Rutherfurrd/Sakura-1---High-Voltage-Power-Distribution-System/MPPT Breakout/jlcpcb/production_files/BOM-MPPT Breakout.csv

Comment | Designator | Footprint | LCSC | Quantity
Wurth 657002230101 | J5 | 657002230101 |  | 1
10A FC-203 | F3 | Fuseholder_Clip-5x20mm_Bel_FC-203-22_Lateral_P17.80x5.00mm_D1.17mm_Horizontal |  | 1
10A FC-203 | F1 | Fuseholder_Clip-5x20mm_Bel_FC-203-22_Lateral_P17.80x5.00mm_D1.17mm_Horizontal |  | 1
1N4007WS | D2 | D_SOD-323_HandSoldering |  | 1
Wurth 657002230101 | J4 | 657002230101 |  | 1
Wurth 657002230101 | J6 | 657002230101 |  | 1
Molex 2218873321 | J3 | CONN_2218873321_KEYOPT1_02P_MOL |  | 1
10A FC-203 | F2 | Fuseholder_Clip-5x20mm_Bel_FC-203-22_Lateral_P17.80x5.00mm_D1.17mm_Horizontal |  | 1
Molex 5569 | J1 | Molex_Mini-Fit_Jr_5569-04A2_2x02_P4.20mm_Horizontal |  | 1
1N4007WS | D3 | D_SOD-323_HandSoldering |  | 1
1N4007WS | D1 | D_SOD-323_HandSoldering |  | 1
1N4007WS | D4 | D_SOD-323_HandSoldering |  | 1
10A FC-203 | F4 | Fuseholder_Clip-5x20mm_Bel_FC-203-22_Lateral_P17.80x5.00mm_D1.17mm_Horizontal |  | 1
Wurth 657002230101 | J7 | 657002230101 |  | 1
Wurth 657002230101 | J8 | 657002230101 |  | 1
Wurth 657002230101 | J10 | 657002230101 |  | 1
Wurth 657002230101 | J11 | 657002230101 |  | 1
Wurth 657002230101 | J9 | 657002230101 |  | 1
