Rutherfurrd/Sakura-1---High-Voltage-Power-Distribution-System/Supplementary Battery Fusebox/jlcpcb/production_files/BOM-Supplementary Breakout.csv

Comment | Designator | Footprint | LCSC | Quantity
3568 Holder | F4 | Fuseholder_Clip-5x20mm_Bel_FC-203-22_Lateral_P17.80x5.00mm_D1.17mm_Horizontal |  | 1
Molex 5569 | J8 | CONN_5569-02A_MOL |  | 1
3568 Holder | F5 | Fuseholder_Clip-5x20mm_Bel_FC-203-22_Lateral_P17.80x5.00mm_D1.17mm_Horizontal |  | 1
XT60 | J1 | XT60PWM |  | 1
3568 Holder | F6 | Fuseholder_Clip-5x20mm_Bel_FC-203-22_Lateral_P17.80x5.00mm_D1.17mm_Horizontal |  | 1
3568 Holder | F3 | Fuseholder_Clip-5x20mm_Bel_FC-203-22_Lateral_P17.80x5.00mm_D1.17mm_Horizontal |  | 1
Molex 5569 | J9 | CONN_5569-02A_MOL |  | 1
3568 Holder | F1 | Fuseholder_Clip-5x20mm_Bel_FC-203-22_Lateral_P17.80x5.00mm_D1.17mm_Horizontal |  | 1
3568 Holder | F7 | Fuseholder_Clip-5x20mm_Bel_FC-203-22_Lateral_P17.80x5.00mm_D1.17mm_Horizontal |  | 1
XT60 | J7 | XT60PWM |  | 1
Molex 5569 | J10 | CONN_5569-02A_MOL |  | 1
Molex 5569 | J12 | CONN_5569-02A_MOL |  | 1
Molex 5569 | J13 | CONN_5569-02A_MOL |  | 1
Molex 5569 | J11 | CONN_5569-02A_MOL |  | 1
3568 Holder | F2 | Fuseholder_Clip-5x20mm_Bel_FC-203-22_Lateral_P17.80x5.00mm_D1.17mm_Horizontal |  | 1
