Rutherfurrd/Sakura-1---High-Voltage-Power-Distribution-System/Mounting/IO Ports.xlsx

Sheet: External
 | Connector | Destination | Marketplace | Link
Motor Controller | ELPA2A1601 | MC | Digikey
 | ELRA2U1601 | MC | Digikey
Supp Battery | XT60 | Supp | Amazon | https://www.amazon.com/XT60E-F-Connector-Protective-Aircraft-Accessories/dp/B0BC5TK8FT
MPPT | ELP2Y03 | MPPT Breakout | Digikey
 | ELR2Y03 | MPPT Breakout | Digikey
CAN Main IN (3P) |  | Telemetry Board
CAN MAIN OUT (3P) |  | Driver Board
CAN MPPT (3P) |  | MPPT
24V Out
GND | 10 Molex Mini Fit | Button Interface | Already owned
PV1 |  | Button Interface
PV2 |  | Button Interface
PV3 |  | Button Interface
3.3V |  | Button Interface
HV_Arm |  | Button Interface
BPS_GND |  | Button Interface
LVESTOP |  | Button Interface
GND |  | Button Interface
HV ESTOP |  | Button Interface
3.3V |  | Button Interface
Coil1 | 6P Molex Minifit | MPPT Breakout | Already Owned
Coil2 |  | MPPT Breakout
Coil3 |  | MPPT Breakout
24V |  | MPPT Breakout
12V_CAN |  | MPPT Breakout
GND |  | MPPT Breakout

Sheet: CAN BUS
Single Connector
 | Sku | Qty | DPN | Price | Total
Socket | 03T-JWPF-VSLE-S | 1 | 455-1188-ND | 1.24
Socket Pins | SWPT-001T-P025 | 2 | 455-1320-1-ND | 0.063
Plug | 03R-JWPF-VSLE-S | 1 | 455-1198-ND | 0.64
Plug Pins | SWPR-001T-P025 | 2 | 455-1321TR-ND | 0.04
20 | Connectors
Socket | 03T-JWPF-VSLE-S | 20 | 24.8
Socket Pins | SWPT-001T-P025 | 40 | 2.52
Plug | 03R-JWPF-VSLE-S | 20 | 12.8
Plug Pins | SWPR-001T-P025 | 40 | 1.6
 |  | Total: | 41.72

Sheet: Sheet2
Black | 30 ft | SKU: NNC2546X
Red | 30 ft | SKU: NNC2548X
White \ | 20 ft | SKU: NNC2549X

Sheet: Internal
Batt+ | Ring Terminal
Batt- | Ring Terminal
IsoSPI | WM1847-ND | 4
 | WM1839-ND | 36
4P Fans | Already Owned
MPPT Micro Fit | WM1785-ND | 5
MPPT Terminal Blocks | 277-8714-ND | 3
