Rutherfurrd/Sakura-1---High-Voltage-Power-Distribution-System/Mounting/CAN Clamp MAIN.SLDPRT

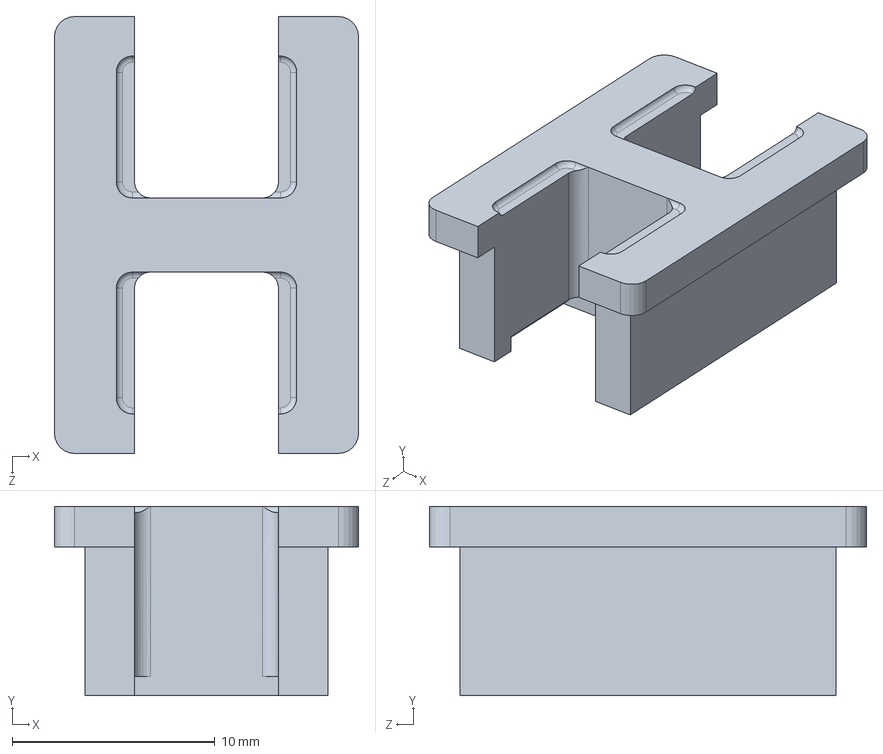
[picture p1: CAD file, 2026-10-22]
Mounting/CAN Clamp MAIN.SLDPRT
15.0 x 9.34 x 21.5 mm
