Rutherfurrd/Sakura-1---High-Voltage-Power-Distribution-System/MPPT Breakout/PCB.step

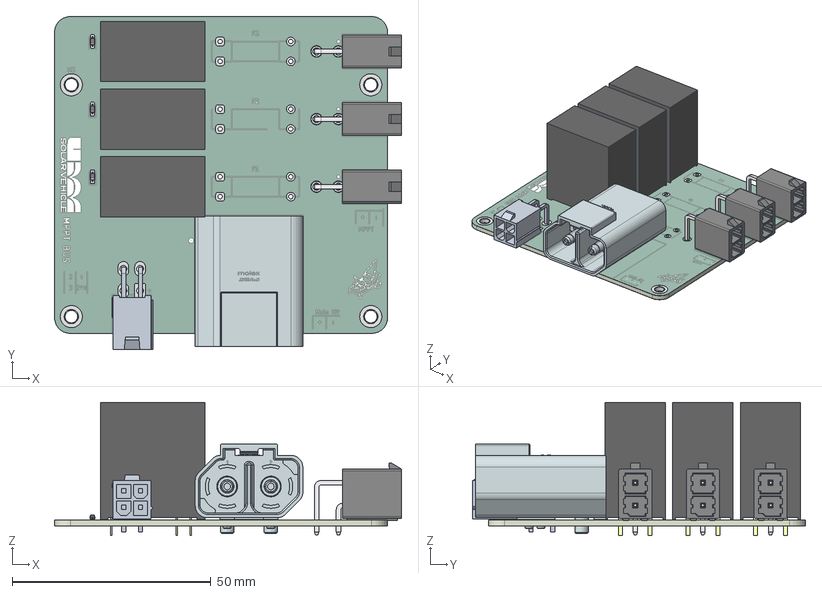
[picture p2: CAD file, 2026-10-22]
MPPT Breakout/PCB.step
87.4 x 83.8 x 33.5 mm
657002230101_Pin1 x 3
657002230101_Pin2 x 3
D_SOD-323 x 3
G5PZ-1A-X_DC24 x 3
MPPT Breakout_copper
MPPT Breakout_pad
MPPT Breakout_via
MPPT Breakout_silkscreen x 2
MPPT Breakout_soldermask x 2
MPPT Breakout_PCB
