Rutherfurrd/Sakura-1---High-Voltage-Power-Distribution-System/Supplementary Battery Fusebox/Supplementary Battery Breakout.step

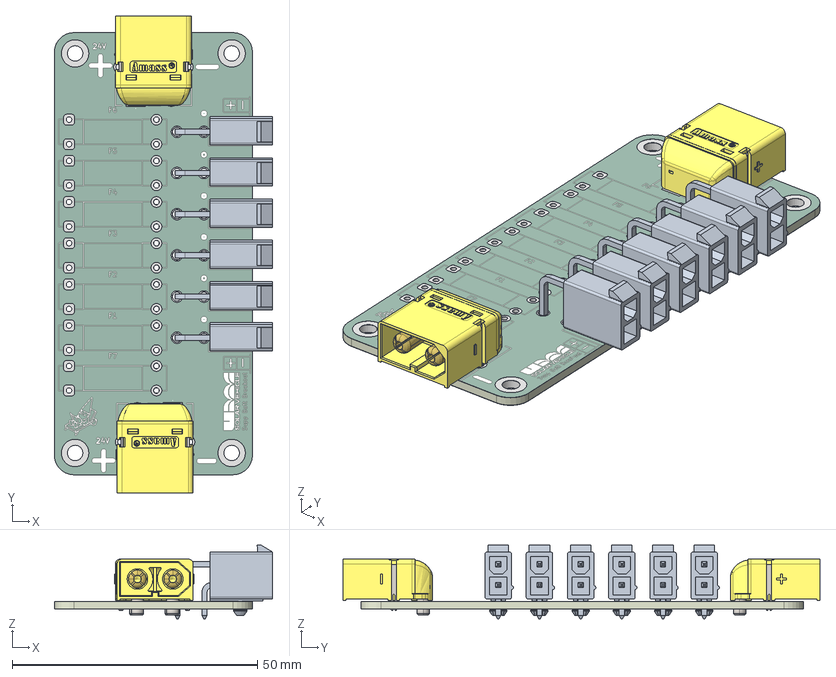
[picture p3: CAD file, 2026-10-22]
Supplementary Battery Fusebox/Supplementary Battery Breakout.step
44.5 x 97.2 x 15.0 mm
XT60PW-M x 2
Supplementary Breakout_copper
Supplementary Breakout_pad
Supplementary Breakout_via
Supplementary Breakout_silkscreen x 2
Supplementary Breakout_soldermask x 2
Supplementary Breakout_PCB
