Rutherfurrd/Sakura-1---High-Voltage-Power-Distribution-System/Mounting/CAN Clamp Right.SLDPRT

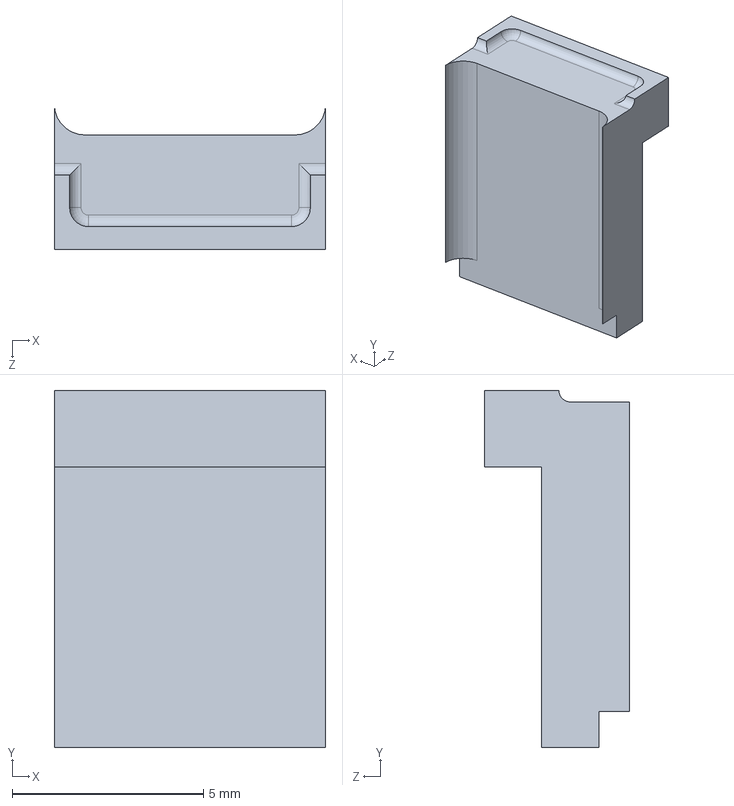
[picture p4: CAD file, 2026-10-22]
Mounting/CAN Clamp Right.SLDPRT
7.10 x 9.34 x 3.80 mm
