Rutherfurrd/Sakura-1---High-Voltage-Power-Distribution-System/MPPT Breakout/MPPT Breakout.step

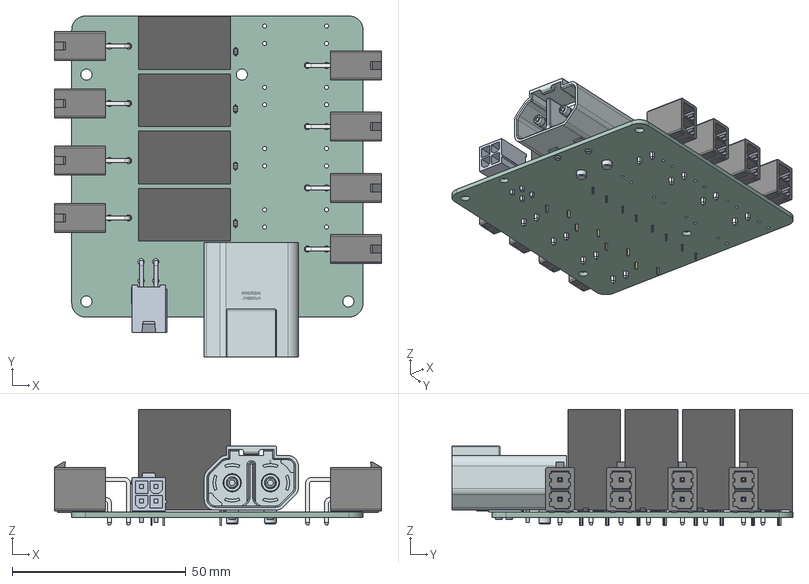
[picture p5: CAD file, 2026-10-22]
MPPT Breakout/MPPT Breakout.step
94.3 x 98.2 x 33.5 mm
657002230101_Pin1 x 8
657002230101_Pin2 x 8
D_SOD-323 x 4
G5PZ_1A_X x 4
MPPT Breakout_PCB
