Rutherfurrd/Sakura-1---High-Voltage-Power-Distribution-System/Power Distribution Board/Battery Board, No Silkscreen.step

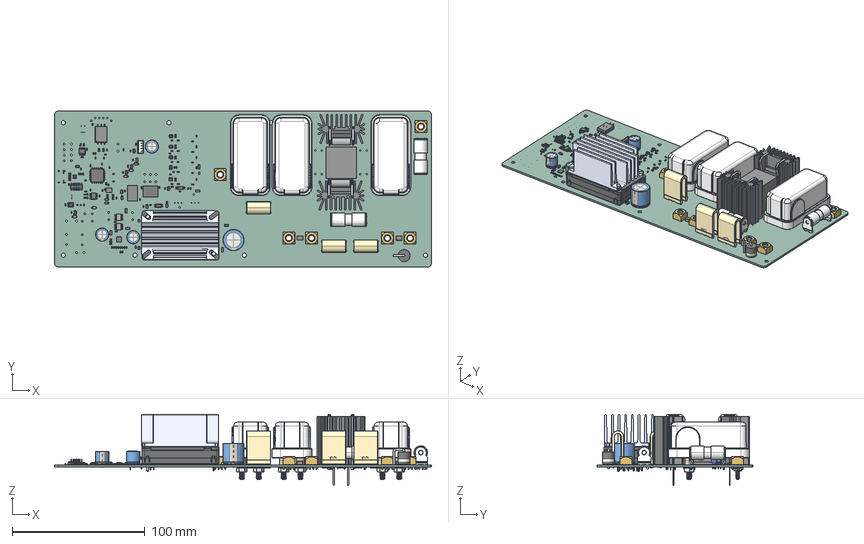
[picture p6: CAD file, 2026-10-22]
Power Distribution Board/Battery Board, No Silkscreen.step
284.3 x 117.7 x 53.8 mm
P125_step_092315 x 3
R_0402_1005Metric x 2
R_0603_1608Metric x 56
C_0603_1608Metric x 56
C_1812_4532Metric x 2
C_1206_3216Metric x 6
C_0805_2012Metric x 2
CP_Radial_D100mm_P500mm x 3
SOT-23-6 x 5
SOT-23 x 14
D_SOD_523 x 4
Converter_DCDC_RECOM_R_78E_05_THT
D_SMF x 10
CP_Radial_D160mm_P750mm
FTR-J2AK012W
R_0805_2012Metric x 3
CN100B110-24
537-95AB HEATSINK DC DC 1-4 BRICK VERT
JST_B4B_PH_K
TO-247-2_Vertical x 2
SW_SPST_PTS810
D_P600_R-6_P7.62mm_Vertical_AnodeUp
PinHeader_2x07_P127mm_Vertical_SMD
LED_0603_1608Metric
QFN-11_L4.5-W3.5-P0.50-TL_TPSM365R6FRDNR
C_0402_1005Metric x 4
D_SOD_123F x 4
SOP_4_44x26mm_P127mm x 2
SOIC-8_3.9x4.9mm_P1.27mm x 2
R_1206_3216Metric
R2A-CT4-38E x 2
RES-TH_HOFLQ60-100A-50MV-7H27 x 3
terminal
logo
TSR 1-2433E
LQFP-64_10x10mm_P0.5mm
ELV10-2P x 2
SOT-23-5
BatteryBoard_PCB
