Rutherfurrd/Sakura-1---High-Voltage-Power-Distribution-System/Supplementary Battery Fusebox/PCB.step

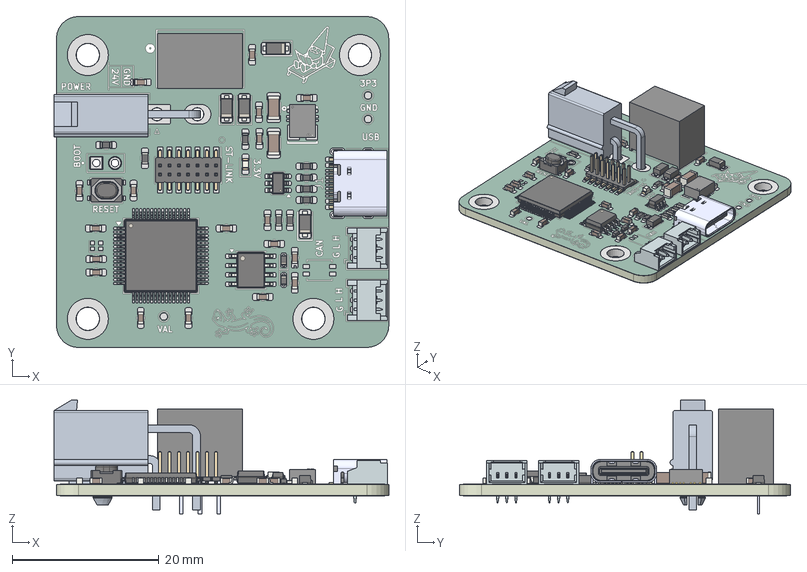
[picture p7: CAD file, 2026-10-22]
Supplementary Battery Fusebox/PCB.step
45.6 x 45.1 x 15.5 mm
D_SOD_523 x 2
530480310wbm000_01 x 2
SOT-23-6
C_0603_1608Metric x 18
R_0603_1608Metric x 9
LED_0603_1608Metric
D_SOD_123F x 4
SW_SPST_PTS810
TSR 1-2433E
PinHeader_2x07_P127mm_Vertical_SMD
SOIC-8_3.9x4.9mm_P1.27mm
C_1206_3216Metric x 2
TYPE-C-31-M-12
LQFP-64_10x10mm_P0.5mm
QFN-11_L4.5-W3.5-P0.50-TL_TPSM365R6FRDNR
Telemetry Board 25-26_copper
Telemetry Board 25-26_pad
Telemetry Board 25-26_via
Telemetry Board 25-26_silkscreen x 2
Telemetry Board 25-26_soldermask x 2
Telemetry Board 25-26_PCB
