Rutherfurrd/Sakura-1---High-Voltage-Power-Distribution-System/Power Distribution Board/spongebob_vectorized.dxf

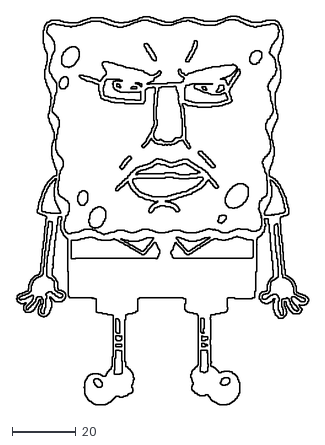
[picture p8: CAD file, 2026-10-22]
Power Distribution Board/spongebob_vectorized.dxf
91.8 x 122.0
