Rutherfurrd/Sakura-1---High-Voltage-Power-Distribution-System/Mounting/IO Insert.STEP

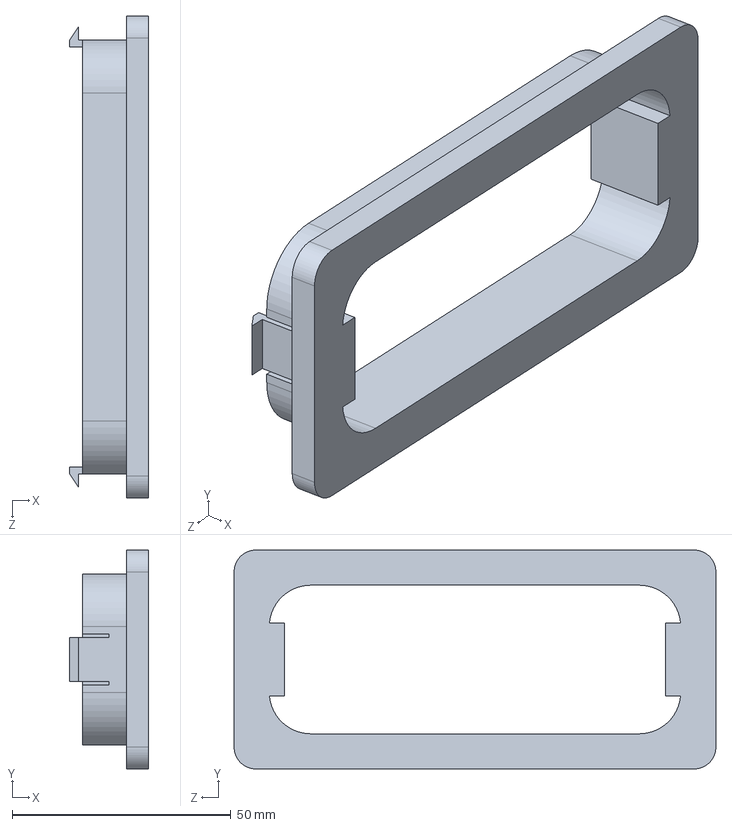
[picture p9: CAD file, 2026-10-22]
Mounting/IO Insert.STEP
18.0 x 50.0 x 110.0 mm
