Rutherfurrd/Sakura-1---High-Voltage-Power-Distribution-System/Mounting/IO-Port - Middle.STEP

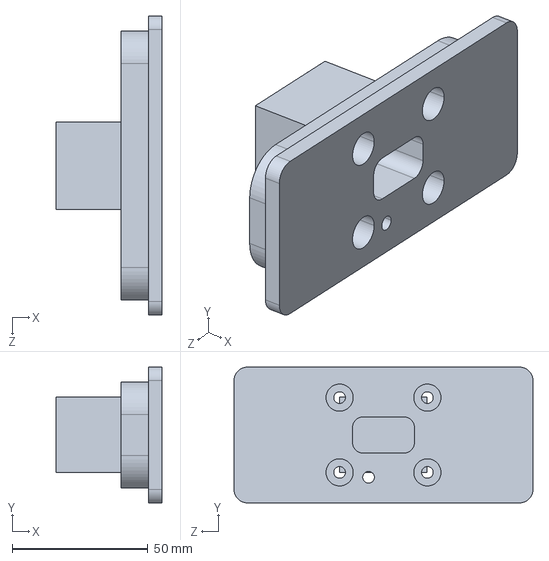
[picture p10: CAD file, 2026-10-22]
Mounting/IO-Port - Middle.STEP
39.0 x 50.0 x 110.0 mm
