Rutherfurrd/Sakura-1---High-Voltage-Power-Distribution-System/Mounting/Connector Mount.STEP

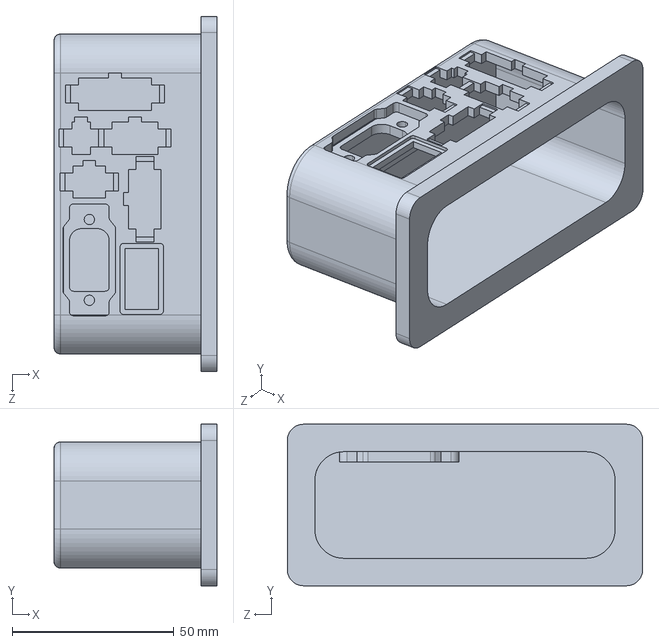
[picture p11: CAD file, 2026-10-22]
Mounting/Connector Mount.STEP
50.5 x 50.0 x 110.0 mm
