Rutherfurrd/Sakura-1---High-Voltage-Power-Distribution-System/Mounting/HV Mount Right.SLDPRT

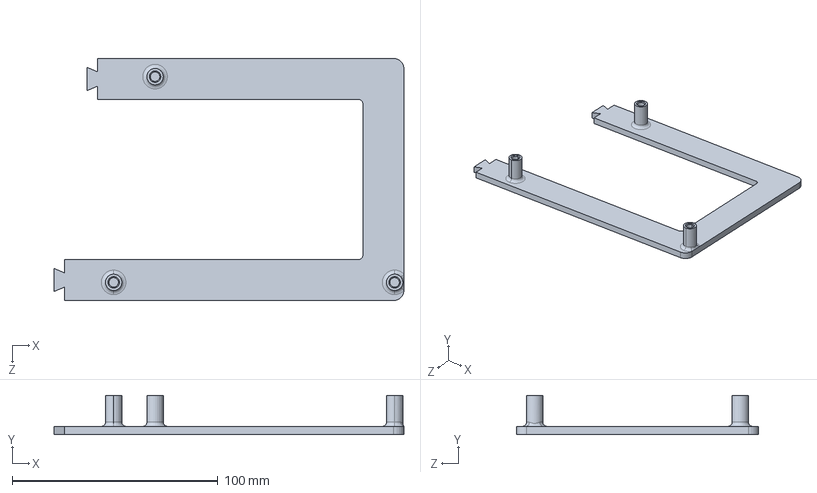
[picture p12: CAD file, 2026-10-22]
Mounting/HV Mount Right.SLDPRT
170.1 x 19.0 x 117.7 mm
