Rutherfurrd/Sakura-1---High-Voltage-Power-Distribution-System/Mounting/HV Mount Left.SLDPRT

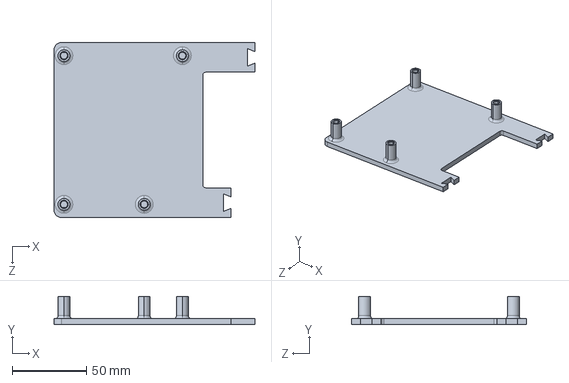
[picture p13: CAD file, 2026-10-22]
Mounting/HV Mount Left.SLDPRT
135.1 x 19.0 x 117.7 mm
