Rutherfurrd/Sakura-1---High-Voltage-Power-Distribution-System/Mounting/Batt_box.STEP

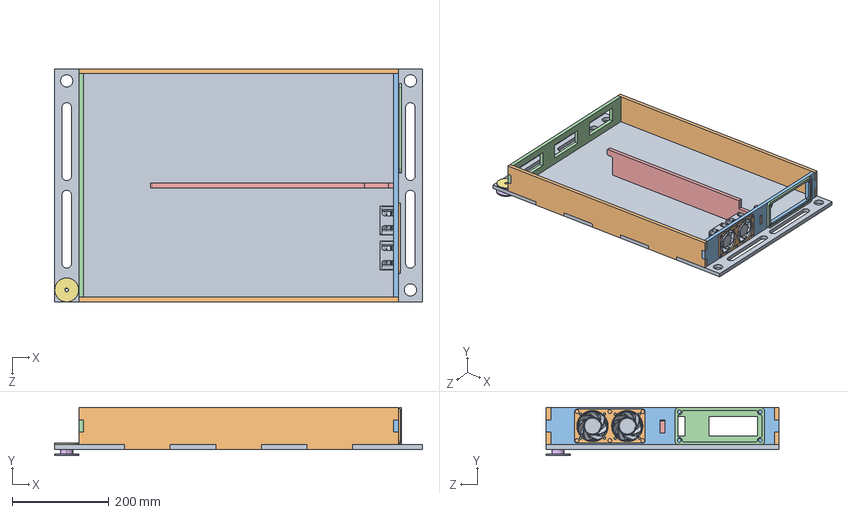
[picture p14: CAD file, 2026-10-22]
Mounting/Batt_box.STEP
761.2 x 99.3 x 482.7 mm
Baseplate
Box Side Wall x 2
Front Wall_1
Rear Wall_2
Middle Wall
Chassis insert 2
Battery Box Insert 2
94820A410_Steel Flex-Top Locknut for Heavy Vibration_94820A410
SanAce_9HV_60x38 - 9HV0612P1J001 v1 x 2
Fan_attachment
Insert_plug
