Rutherfurrd/Sakura-1---High-Voltage-Power-Distribution-System/Mounting/IO-Port - Right.STEP

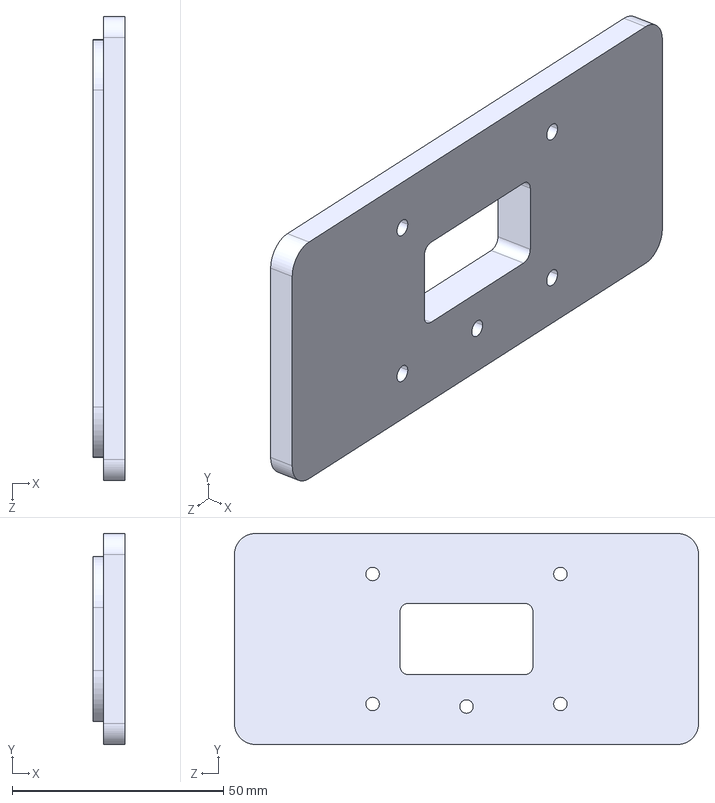
[picture p15: CAD file, 2026-10-22]
Mounting/IO-Port - Right.STEP
7.50 x 50.0 x 110.0 mm
