Rutherfurrd/Sakura-1---High-Voltage-Power-Distribution-System/Mounting/Batt_box_assem.SLDASM

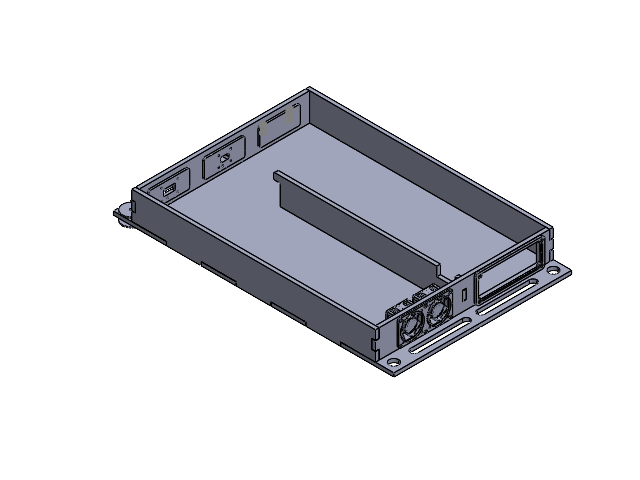
[picture p16: CAD file, 2026-10-22]
Mounting/Batt_box_assem.SLDASM
Baseplate.STEP
Box Side Wall_1.STEP x 2
Front Wall_1_1.STEP
Rear Wall_2_1.STEP
Middle Wall_1.STEP
Chassis insert 2_1.STEP
Battery Box Insert 2_1.STEP
94820A410_Steel Flex-Top Locknut for Heavy Vibration_94820A410_1.STEP
SanAce_9HV_60x38 - 9HV0612P1J001 v1_1.STEP x 2
Fan_attachment_1.STEP
Part6.STEP
Part7_1.STEP
Insert_plug_1.STEP
IO-Port
IO-Port - Middle
IO-Port - Right
