Rutherfurrd/Sakura-1---High-Voltage-Power-Distribution-System/(list of files, cad)

Other CAD files:
Power Distribution Board/Battery Board.step
Mounting/CAN Clamp Left.SLDPRT
Mounting/IO-Port.SLDPRT
Mounting/Connector Mount.SLDASM
Mounting/IO-Port - Middle.3mf
Mounting/IO-Port - Middle.SLDPRT
Mounting/IO-Port - Right.SLDPRT
