Rutherfurrd/Sakura-1---High-Voltage-Power-Distribution-System/Schematics/HV Power Distribution Board - PCB.pdf

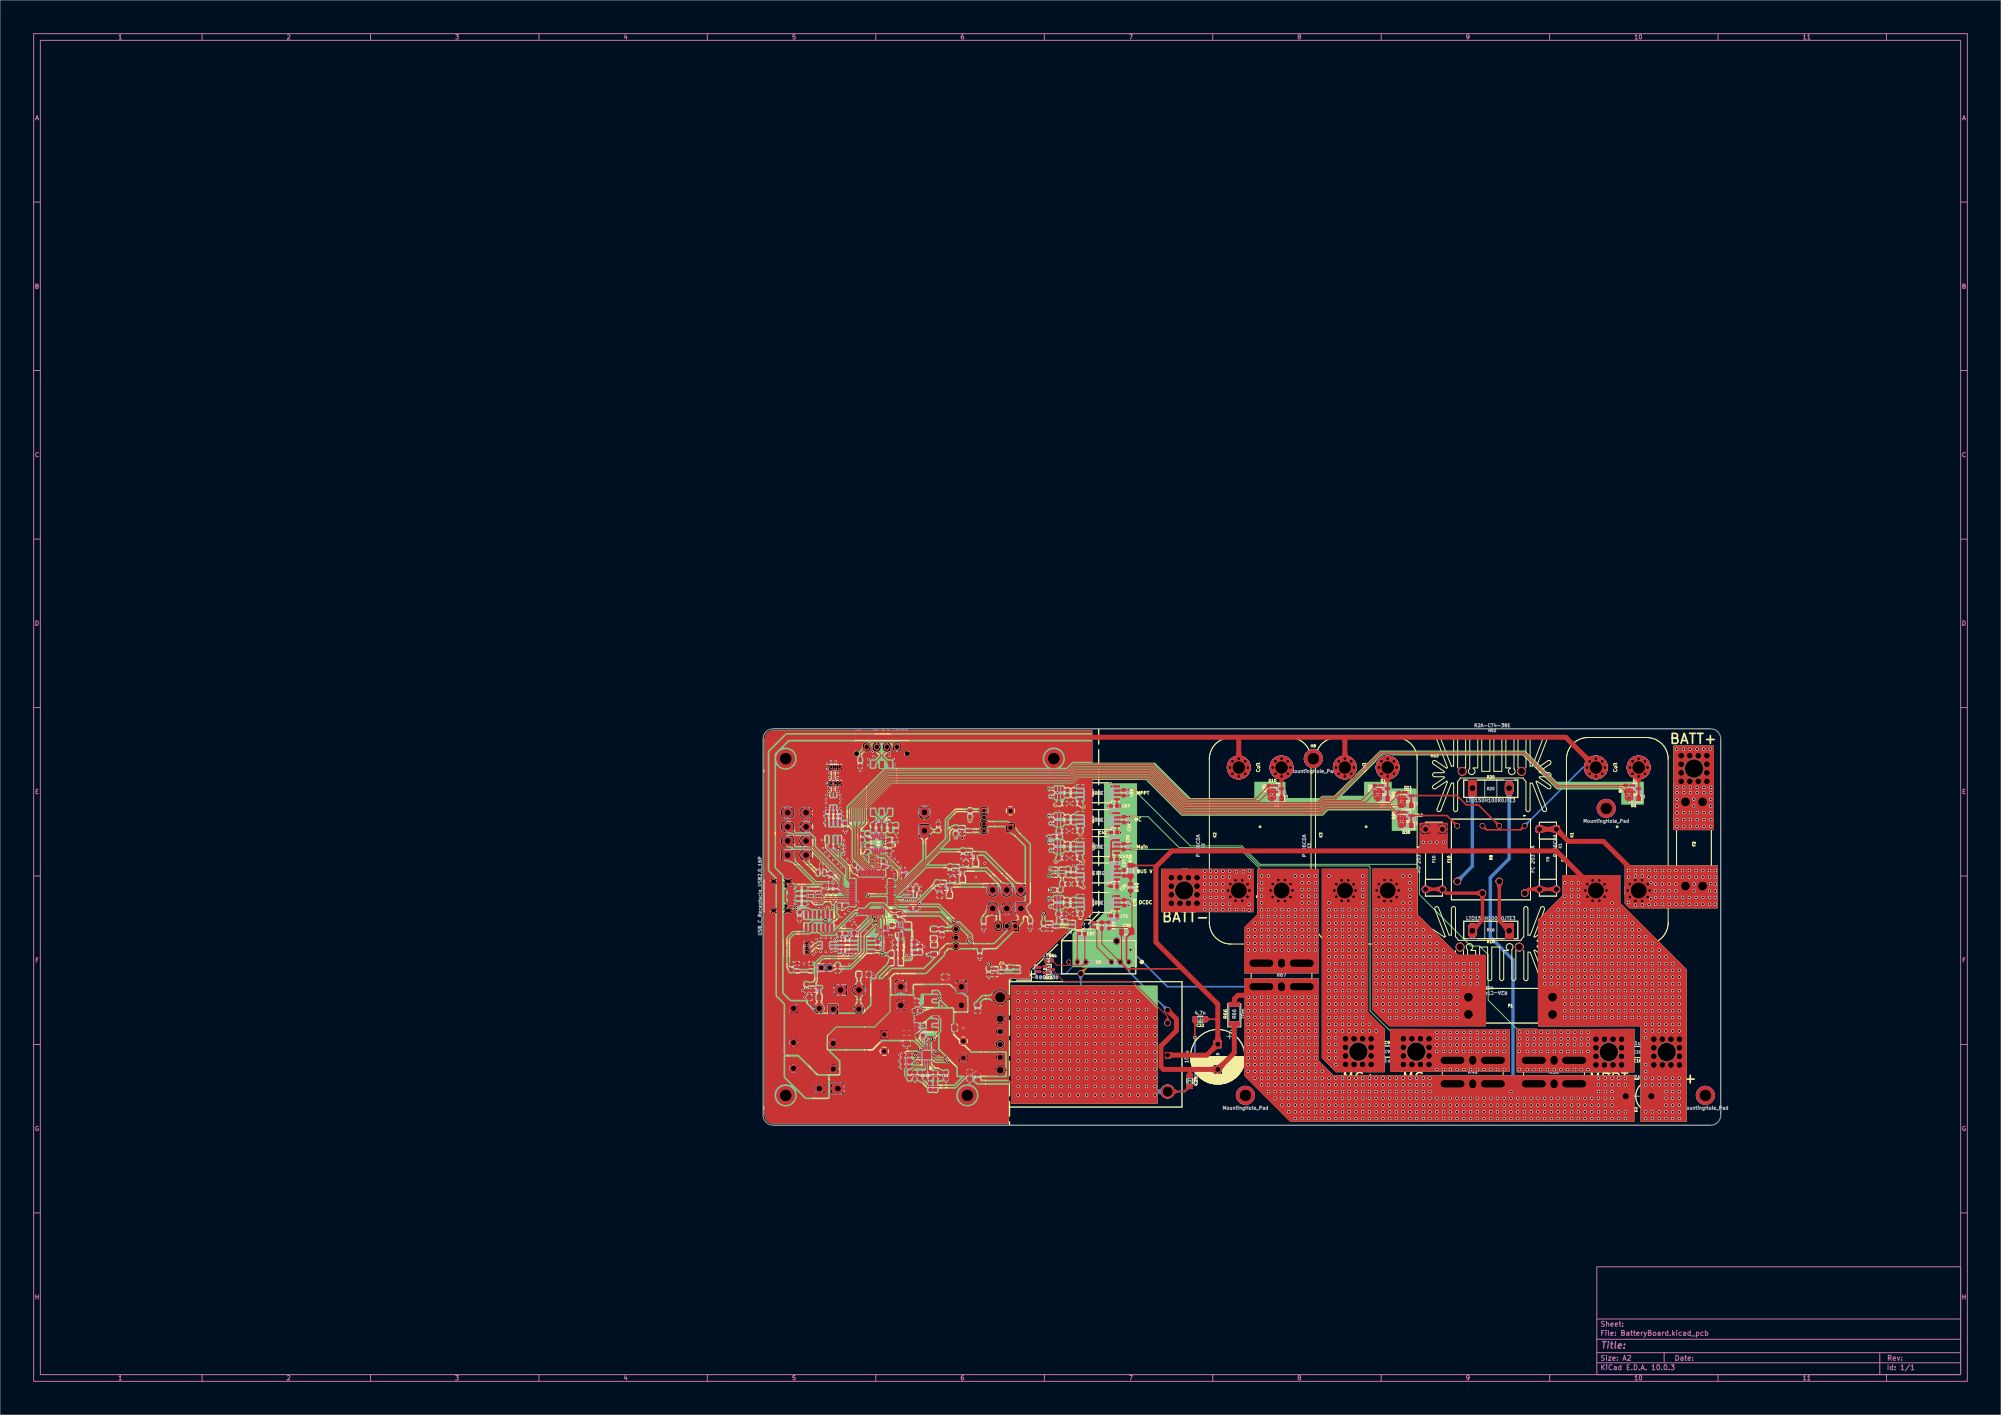
[picture p17: page 1]
