Rutherfurrd/Sakura-1---High-Voltage-Power-Distribution-System/MPPT Breakout/MPPT Breakout.kicad_pcb

## KiCad design MPPT Breakout/MPPT Breakout.kicad_pcb (2026-10-22)

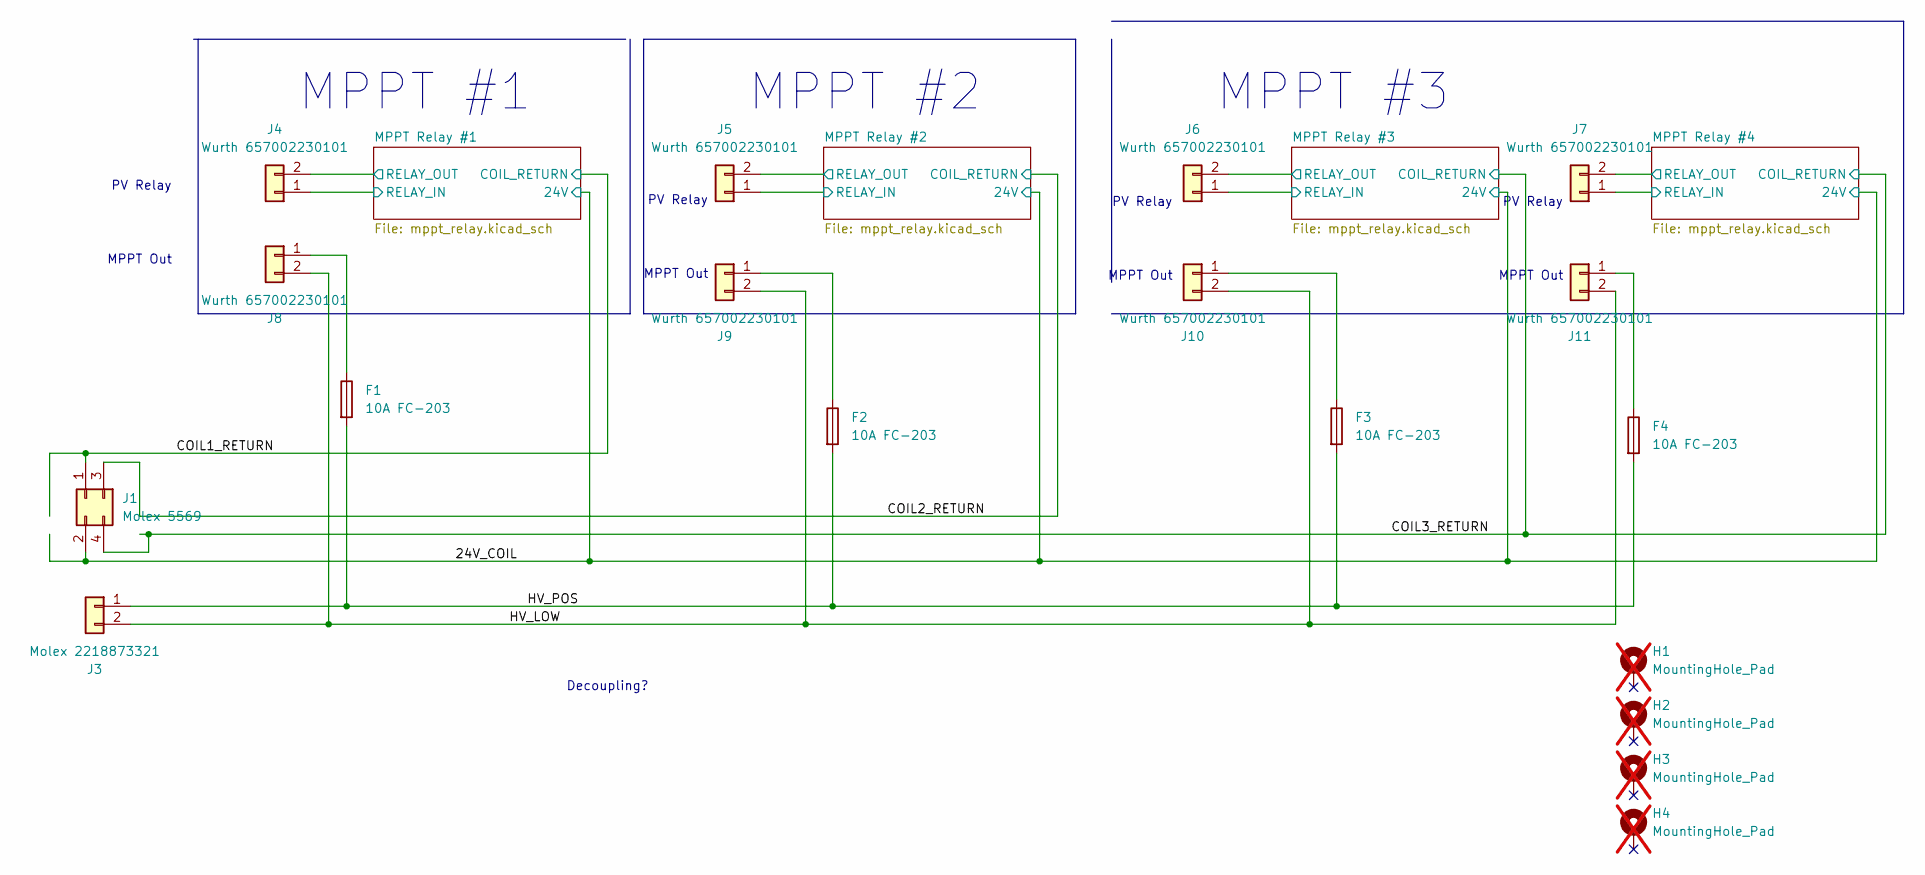
[picture p45: schematic MPPT Breakout.kicad_sch]

Parts:
F1, F2, F3, F4: 10A FC-203; Fuseholder_Clip-5x20mm_Bel_FC-203-22_Lateral_P17.80x5.00mm_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; Digikey SID 5923-FC-203BRIGHTTIN-ND
H1, H2, H3, H4: MountingHole_Pad; MountingHole_3.2mm_M3_DIN965_Pad_TopBottom; not fitted
J1: Molex 5569; Molex_Mini-Fit_Jr_5569-04A2_2x02_P4.20mm_Horizontal; Digikey SID WM23323-ND
J3: Molex 2218873321; CONN_2218873321_KEYOPT1_02P_MOL; Digikey SID 900-2218873321-ND
J4, J5, J6, J7, J8, J9, J10, J11: Wurth 657002230101; 657002230101; Digikey SID 732-657002230101-ND

Connections:
/24V_COIL: J1.2 (Pin_3); also elsewhere on the board
/COIL1_RETURN: J1.1 (Pin_2); also elsewhere on the board
/COIL2_RETURN: J1.3 (Pin_1); also elsewhere on the board
/COIL3_RETURN: J1.4; also elsewhere on the board
/HV_LOW: J3.2, J8.2, J9.2, J10.2, J11.2
/HV_POS: F1.2, F2.2, F3.2, F4.2, J3.1
/MPPT Relay #1/RELAY_IN: J4.1; also elsewhere on the board
/MPPT Relay #1/RELAY_OUT: J4.2; also elsewhere on the board
/MPPT Relay #2/RELAY_IN: J5.1; also elsewhere on the board
/MPPT Relay #2/RELAY_OUT: J5.2; also elsewhere on the board
/MPPT Relay #3/RELAY_IN: J6.1; also elsewhere on the board
/MPPT Relay #3/RELAY_OUT: J6.2; also elsewhere on the board
/MPPT Relay #4/RELAY_IN: J7.1; also elsewhere on the board
/MPPT Relay #4/RELAY_OUT: J7.2; also elsewhere on the board
unnamed: F1.1, J8.1
unnamed: F2.1, J9.1
unnamed: F3.1, J10.1
unnamed: F4.1, J11.1

Notes on the sheet:
MPPT Out
Decoupling?
MPPT #3
PV Relay
MPPT #1
MPPT #2

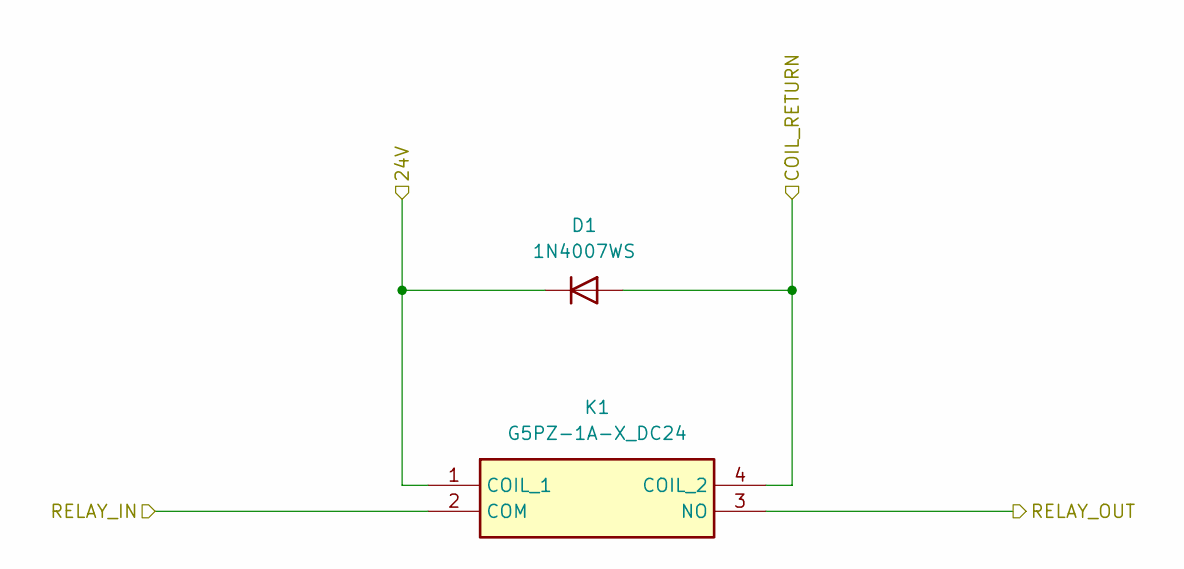
[picture p46: schematic mppt_relay.kicad_sch]

Parts:
D1: 1N4007WS; D_SOD-323_HandSoldering; Digikey SID 5399-1N4007WSCT-ND
K1: G5PZ-1A-X_DC24; G5PZ1AXDC24; Mouser Part Number 653-G5PZ-1A-XDC24

Connections:
/24V_COIL: D1.1 (K), K1.1 (COIL_1); also elsewhere on the board
/COIL1_RETURN: D1.2 (A), K1.4 (COIL_2); also elsewhere on the board
/MPPT Relay #1/RELAY_IN: K1.2 (COM); also elsewhere on the board
/MPPT Relay #1/RELAY_OUT: K1.3 (NO); also elsewhere on the board

Parts of its further copies:
D2, D3, D4: 1N4007WS; D_SOD-323_HandSoldering; Digikey SID 5399-1N4007WSCT-ND
K2, K3, K4: G5PZ-1A-X_DC24; G5PZ1AXDC24; Mouser Part Number 653-G5PZ-1A-XDC24

Connections of its further copies:
/24V_COIL: D2.1 (K), D3.1 (K), D4.1 (K), K2.1 (COIL_1), K3.1 (COIL_1), K4.1 (COIL_1); also elsewhere on the board
/COIL2_RETURN: D2.2 (A), K2.4 (COIL_2); also elsewhere on the board
/COIL3_RETURN: D3.2 (A), D4.2 (A), K3.4 (COIL_2), K4.4 (COIL_2); also elsewhere on the board
/MPPT Relay #2/RELAY_IN: K2.2 (COM); also elsewhere on the board
/MPPT Relay #2/RELAY_OUT: K2.3 (NO); also elsewhere on the board
/MPPT Relay #3/RELAY_IN: K3.2 (COM); also elsewhere on the board
/MPPT Relay #3/RELAY_OUT: K3.3 (NO); also elsewhere on the board
/MPPT Relay #4/RELAY_IN: K4.2 (COM); also elsewhere on the board
/MPPT Relay #4/RELAY_OUT: K4.3 (NO); also elsewhere on the board

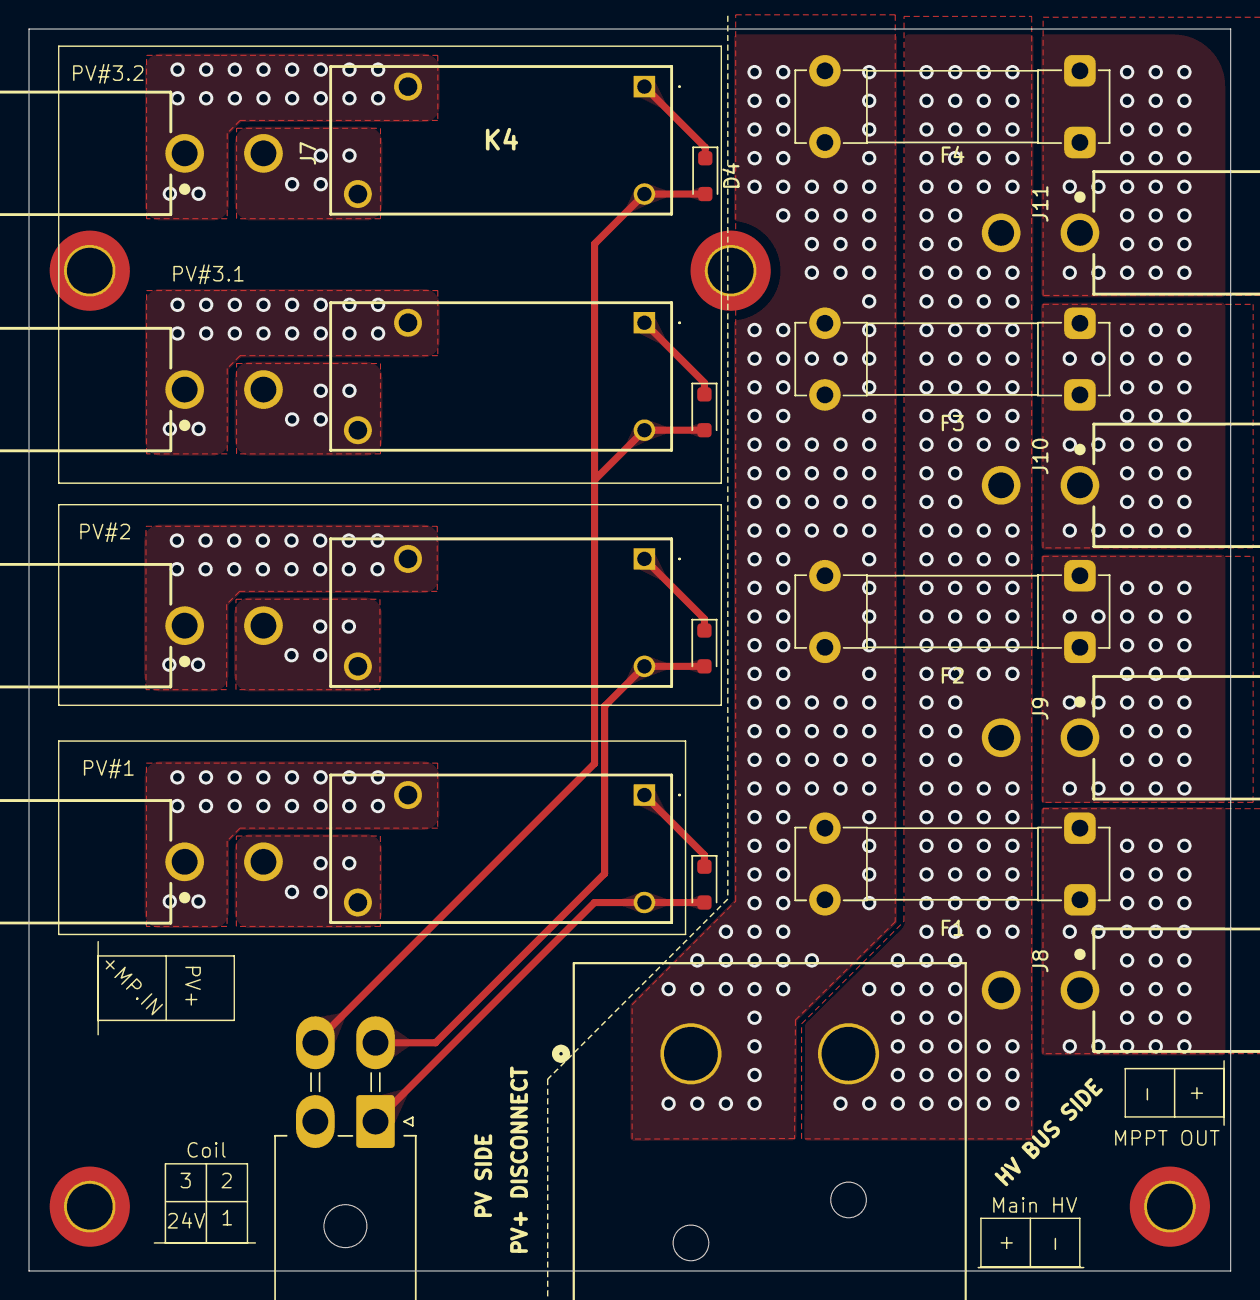
[picture p47: board MPPT Breakout.kicad_pcb from above]

Board: 4 copper layers, 83.9 x 86.7 mm, 26 parts (0 on the bottom side), 18 nets.
