Rutherfurrd/Sakura-1---High-Voltage-Power-Distribution-System/Power Distribution Board/BatteryBoard.kicad_pcb

## KiCad design Power Distribution Board/BatteryBoard.kicad_pcb (2026-10-22)

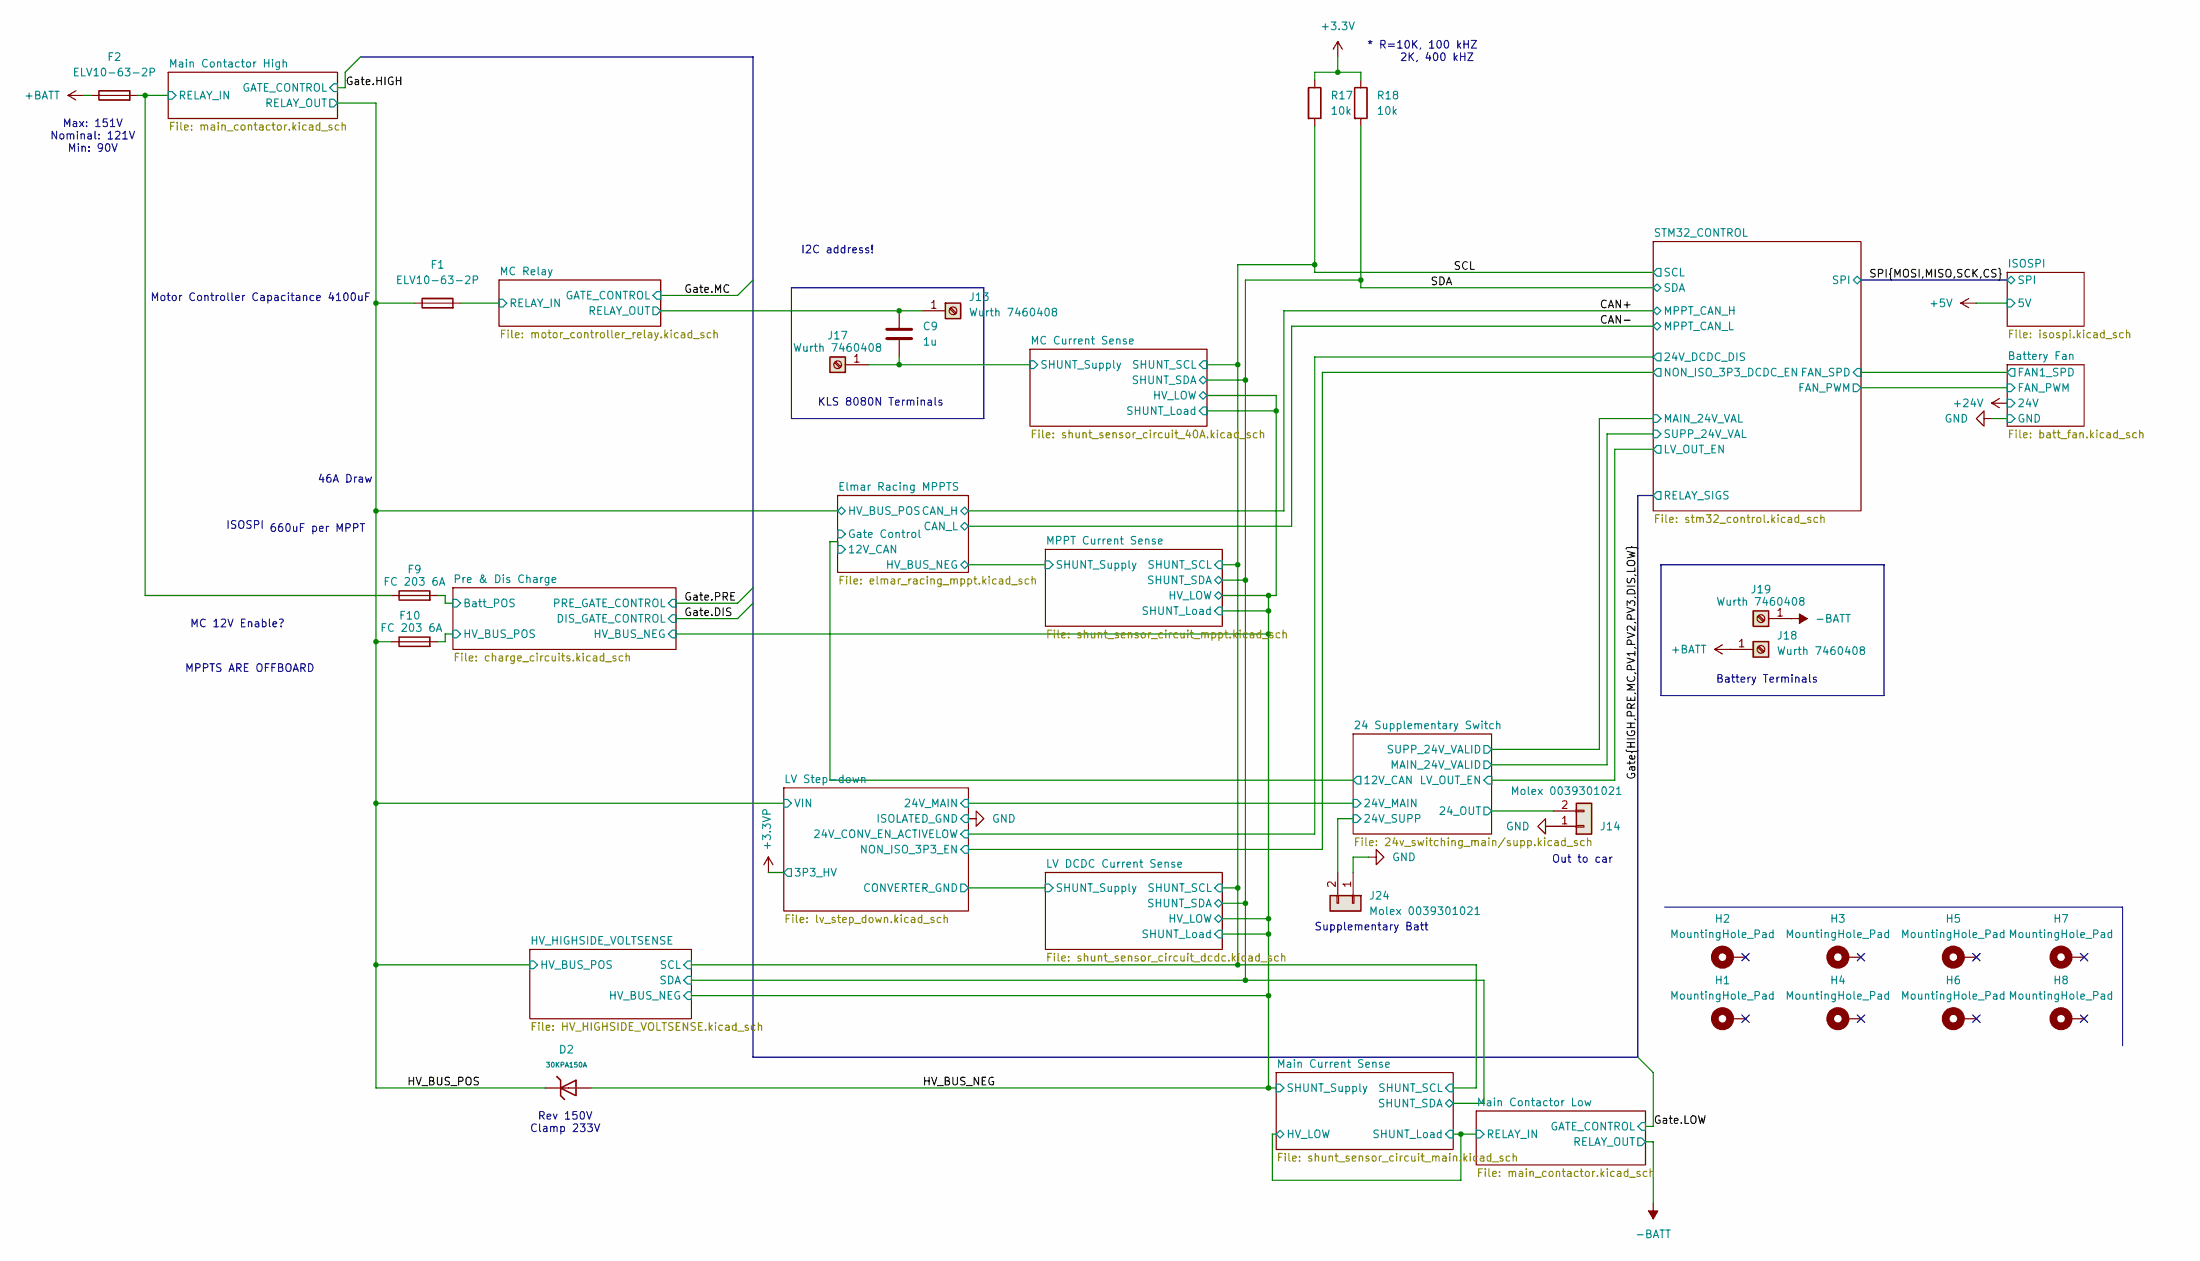
[picture p48: schematic BatteryBoard.kicad_sch]

Parts:
C9: 1u; C_1812_4532Metric; LCSC C3037685
D2: 30KPA150A; D_P600_R-6_P7.62mm_Vertical_AnodeUp; DigiKey_Part_Number 30KPA150ACT-ND
F1, F2: ELV10-63-2P; ELV10-XX-2P; DigiKey_Part_Number 283-ELV10-63-2P-ND
F9, F10: FC 203 6A; Fuseholder_Clip-5x20mm_Bel_FC-203-22_Lateral_P17.80x5.00mm_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; DigiKey_Part_Number 5923-FC-203BRIGHTTIN-ND
H1, H2, H3, H4, H5, H6, H7, H8: MountingHole_Pad; MountingHole_3.2mm_M3_DIN965_Pad_TopBottom
J13, J17, J18, J19: Wurth 7460408; MP_Wurth_WP-BUCF_7460408; DigiKey_Part_Number 732-7460408-ND
J14, J24: Molex 0039301021; Molex_Mini-Fit_Jr_5566-02A_2x01_P4.20mm_Vertical; DigiKey_Part_Number WM3843-ND
R17, R18: 10k; R_0603_1608Metric_Pad0.98x0.95mm_HandSolder; Rating 75V; LCSC C95204

Connections:
+3.3V: R17.1, R18.1; also elsewhere on the board
+BATT: F2.1, J18.1 (Pin_1_1)
-BATT: J19.1 (Pin_1_1); also elsewhere on the board
/24 Supplementary Switch/24V_SUPP: J24.2; also elsewhere on the board
/24 Supplementary Switch/24_OUT: J14.2; also elsewhere on the board
/<NO NET>: R17.2; also elsewhere on the board
/HV_BUS_NEG: D2.2; also elsewhere on the board
/HV_BUS_POS: D2.1, F1.1, F10.1; also elsewhere on the board
/MC Current Sense/SHUNT_Supply: C9.2, J17.1 (Pin_1_1); also elsewhere on the board
/MC Relay/RELAY_IN: F1.2; also elsewhere on the board
/MC Relay/RELAY_OUT: C9.1, J13.1 (Pin_1_1); also elsewhere on the board
/Main Contactor High/RELAY_IN: F2.2, F9.1; also elsewhere on the board
/Pre & Dis Charge/Batt_POS: F9.2; also elsewhere on the board
/Pre & Dis Charge/HV_BUS_POS: F10.2; also elsewhere on the board
/SDA: R18.2; also elsewhere on the board
GND: J14.1, J24.1; also elsewhere on the board

Notes on the sheet:
ISOSPI
MPPTS ARE OFFBOARD
Supplementary Batt
Out to car
MC 12V Enable?
Motor Controller Capacitance 4100uF
I2C address!
660uF per MPPT
Rev 150V Clamp 233V
* R=10K, 100 kHZ 2K, 400 kHZ
KLS 8080N Terminals
Max: 151V Nominal: 121V Min: 90V
Battery Terminals
46A Draw

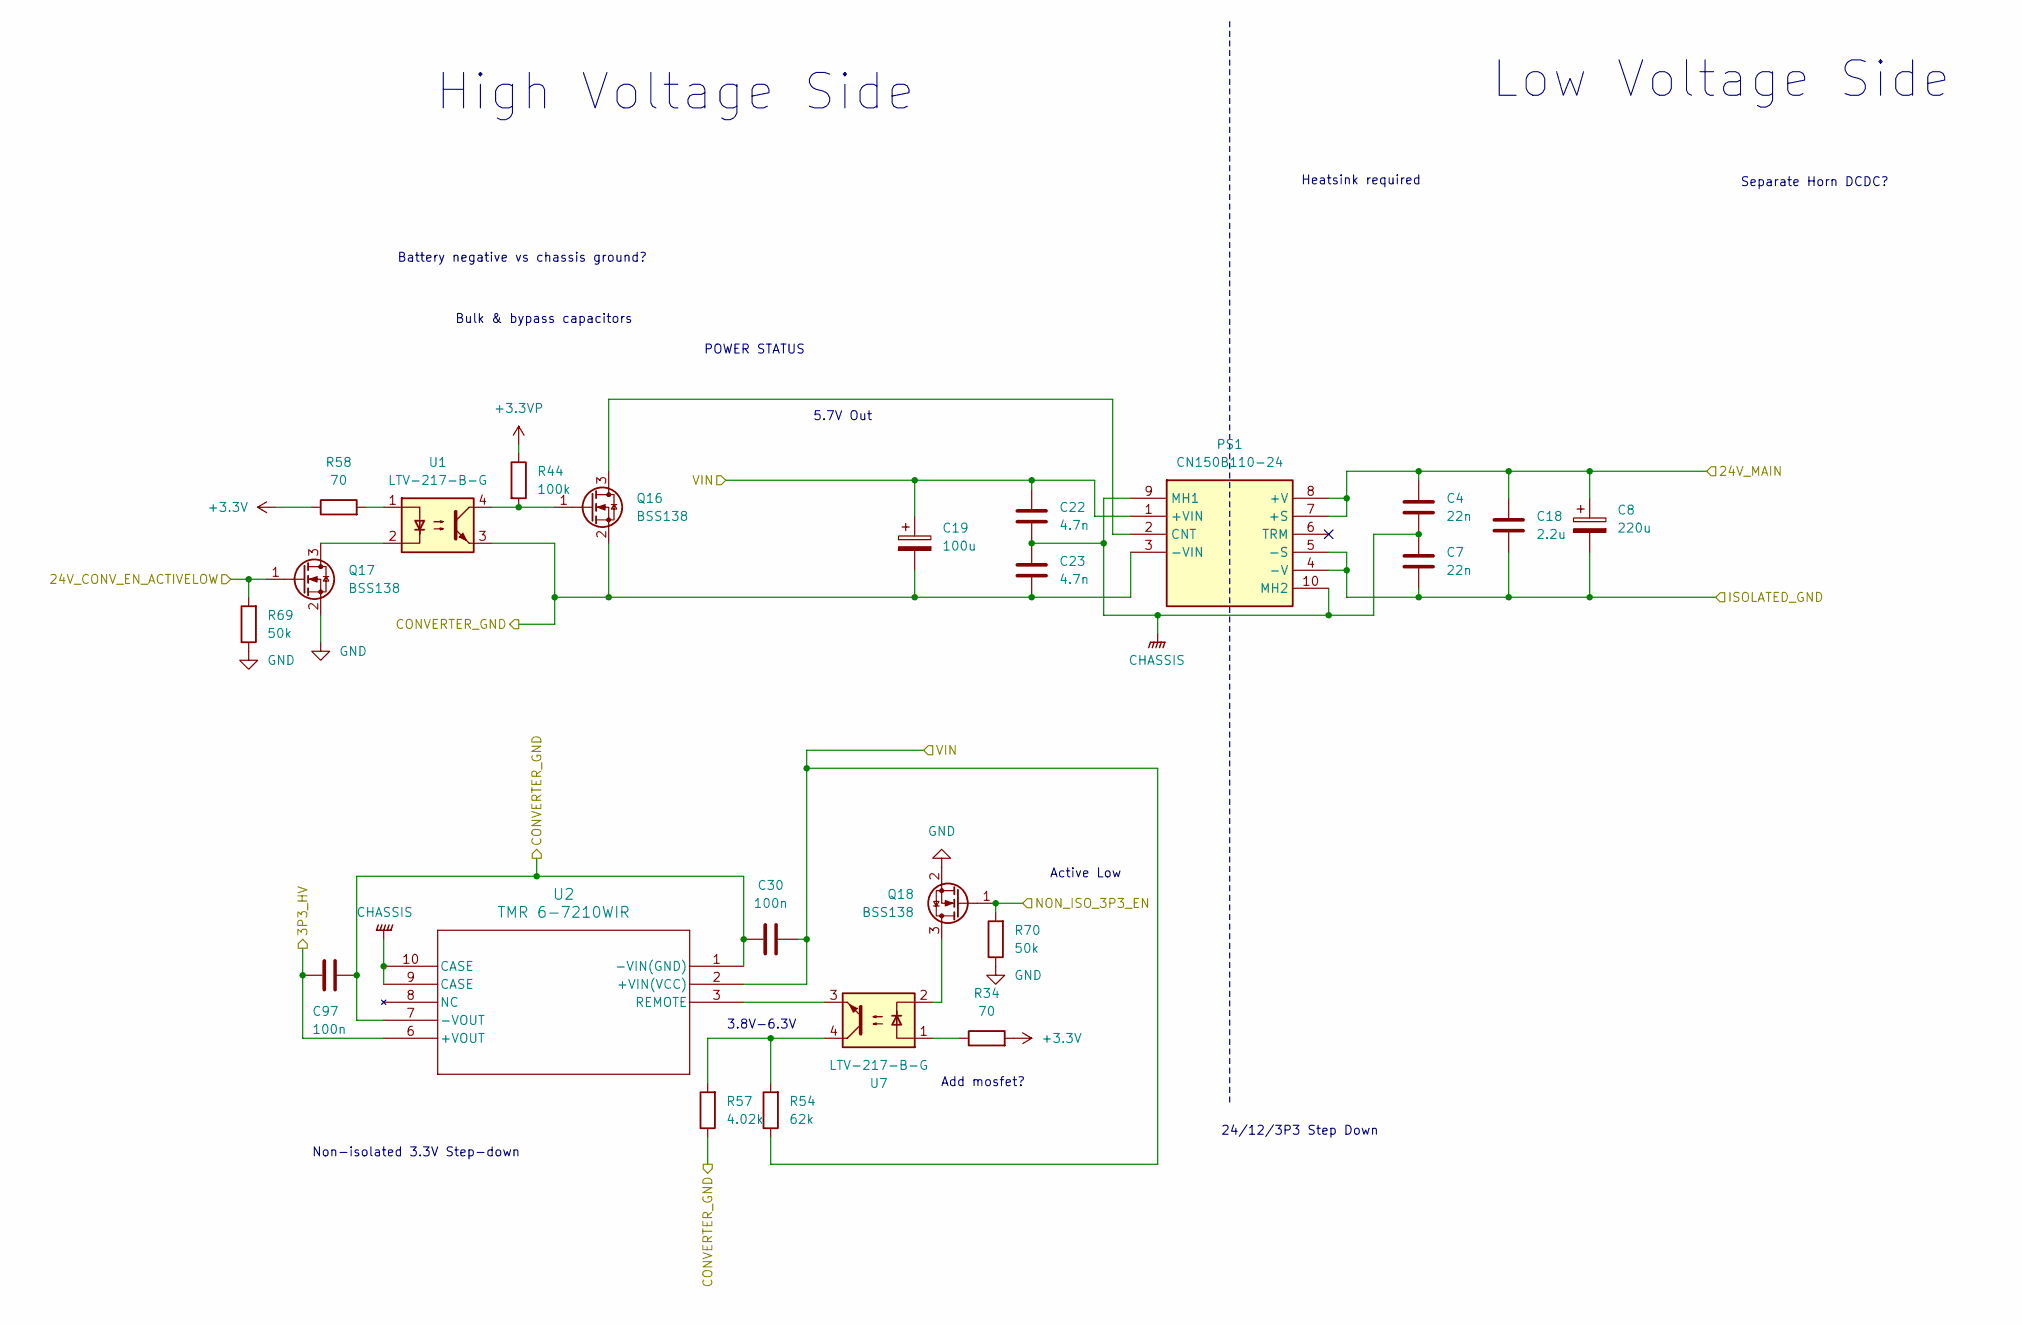
[picture p49: schematic lv_step_down.kicad_sch]

Parts:
C4, C7: 22n; R_0805_2012Metric; LCSC C1729
C8: 220u; CP_Radial_D10.0mm_P5.00mm; DigiKey_Part_Number CAP ALUM 220UF 20% 50V RADIAL TH
C18: 2.2u; C_0805_2012Metric_Pad1.18x1.45mm_HandSolder; LCSC C377773
C19: 100u; CP_Radial_D16.0mm_P7.50mm; DigiKey_Part_Number UCS2E101MHD
C22, C23: 4.7n; C_1206_3216Metric_Pad1.33x1.80mm_HandSolder; LCSC C106075
C30: 100n; C_1206_3216Metric_Pad1.33x1.80mm_HandSolder; LCSC C76671
C97: 100n; C_0603_1608Metric_Pad1.08x0.95mm_HandSolder; Rating 50V; LCSC C14663
PS1: CN150B110-24; CN100B11024; Mouser Part Number 967-CN100B110-24
Q16, Q17, Q18: BSS138; SOT-23; LCSC C7420339
R34, R58: 70; R_0603_1608Metric_Pad0.98x0.95mm_HandSolder; Rating 70V; LCSC C4275
R44: 100k; R_0603_1608Metric_Pad0.98x0.95mm_HandSolder; LCSC C25803
R54: 62k; C_0603_1608Metric_Pad1.08x0.95mm_HandSolder; Rating 200V; LCSC C403521
R57: 4.02k; R_0603_1608Metric_Pad0.98x0.95mm_HandSolder; Rating 75V; LCSC C242164
R69, R70: 50k; R_0603_1608Metric_Pad0.98x0.95mm_HandSolder; Rating 70V; LCSC C23184
U1, U7: LTV-217-B-G; SOP-4_4.4x2.6mm_P1.27mm; Part LTV-217-B-G; LCSC C115450
U2: TMR 6-7210WIR; TMR6WIR-SINGLE_TRP; DigiKey_Part_Number 1951-2031-ND

Connections:
+3.3V: R34.2, R58.1; also elsewhere on the board
+3.3VP: C97.2, R44.1, U2.6 (+VOUT); also elsewhere on the board
/24 Supplementary Switch/24V_MAIN: C4.1, C8.1, C18.1, PS1.7 (+S), PS1.8 (+V); also elsewhere on the board
/HV_BUS_POS: C19.1, C22.1, C30.1, PS1.1 (+VIN), R54.1, U2.2 (+VIN(VCC)); also elsewhere on the board
/LV DCDC Current Sense/SHUNT_Supply: C19.2, C23.2, C30.2, C97.1, PS1.3 (-VIN), Q16.2 (S), R57.1, U1.3, U2.1 (-VIN(GND)), U2.7 (-VOUT); also elsewhere on the board
/LV Step-down/24V_CONV_EN_ACTIVELOW: Q17.1 (G), R69.2; also elsewhere on the board
/LV Step-down/NON_ISO_3P3_EN: Q18.1 (G), R70.2; also elsewhere on the board
CHASSIS: C4.2, C7.1, C22.2, C23.1, PS1.9 (MH1), PS1.10 (MH2), U2.9 (CASE), U2.10 (CASE)
GND: C7.2, C8.2, C18.2, PS1.4 (-V), PS1.5 (-S), Q17.2 (S), Q18.2 (S), R69.1, R70.1; also elsewhere on the board
unnamed: PS1.2 (CNT), Q16.3 (D)
unnamed: Q16.1 (G), R44.2, U1.4
unnamed: Q17.3 (D), U1.2
unnamed: Q18.3 (D), U7.2
unnamed: R34.1, U7.1
unnamed: R54.2, R57.2, U7.4
unnamed: R58.2, U1.1
unnamed: U2.3 (REMOTE), U7.3

Notes on the sheet:
Active Low
Separate Horn DCDC?
Bulk & bypass capacitors
High Voltage Side
24/12/3P3 Step Down
Low Voltage Side
Battery negative vs chassis ground?
Add mosfet?
POWER STATUS
3.8V-6.3V
Non-isolated 3.3V Step-down
Heatsink required
5.7V Out

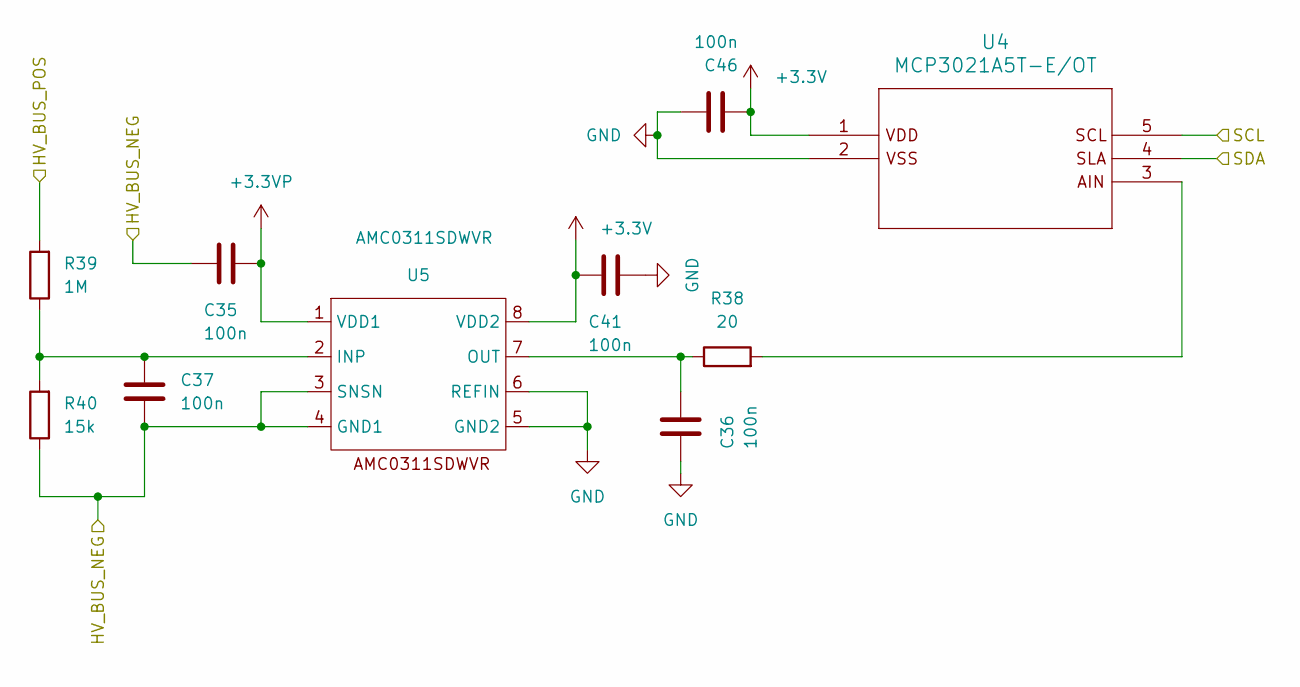
[picture p50: schematic HV_HIGHSIDE_VOLTSENSE.kicad_sch]

Parts:
C35, C36, C37, C41, C46: 100n; C_0603_1608Metric_Pad1.08x0.95mm_HandSolder; Rating 50V; LCSC C14663
R38: 20; R_0603_1608Metric_Pad0.98x0.95mm_HandSolder; Rating 75V; LCSC C22950
R39: 1M; R_1206_3216Metric_Pad1.30x1.75mm_HandSolder; Rating 200V; LCSC C17927
R40: 15k; C_0805_2012Metric; Rating 200V; LCSC C17475
U4: MCP3021A5T-E/OT; SOT-23-5; LCSC C128576
U5: AMC0311SDWVR; DWV0008A; LCSC C44211429

Connections:
+3.3V: C41.2, C46.2, U4.1, U5.8 (VDD2); also elsewhere on the board
+3.3VP: C35.1, U5.1 (VDD1); also elsewhere on the board
/<NO NET>: U4.5; also elsewhere on the board
/HV_BUS_NEG: C35.2, C37.2, R40.1, U5.3 (SNSN), U5.4 (GND1); also elsewhere on the board
/HV_BUS_POS: R39.2; also elsewhere on the board
/SDA: U4.4; also elsewhere on the board
GND: C36.2, C41.1, C46.1, U4.2, U5.5 (GND2), U5.6 (REFIN); also elsewhere on the board
unnamed: R38.2, U4.3
unnamed: C37.1, R39.1, R40.2, U5.2 (INP)
unnamed: C36.1, R38.1, U5.7 (OUT)

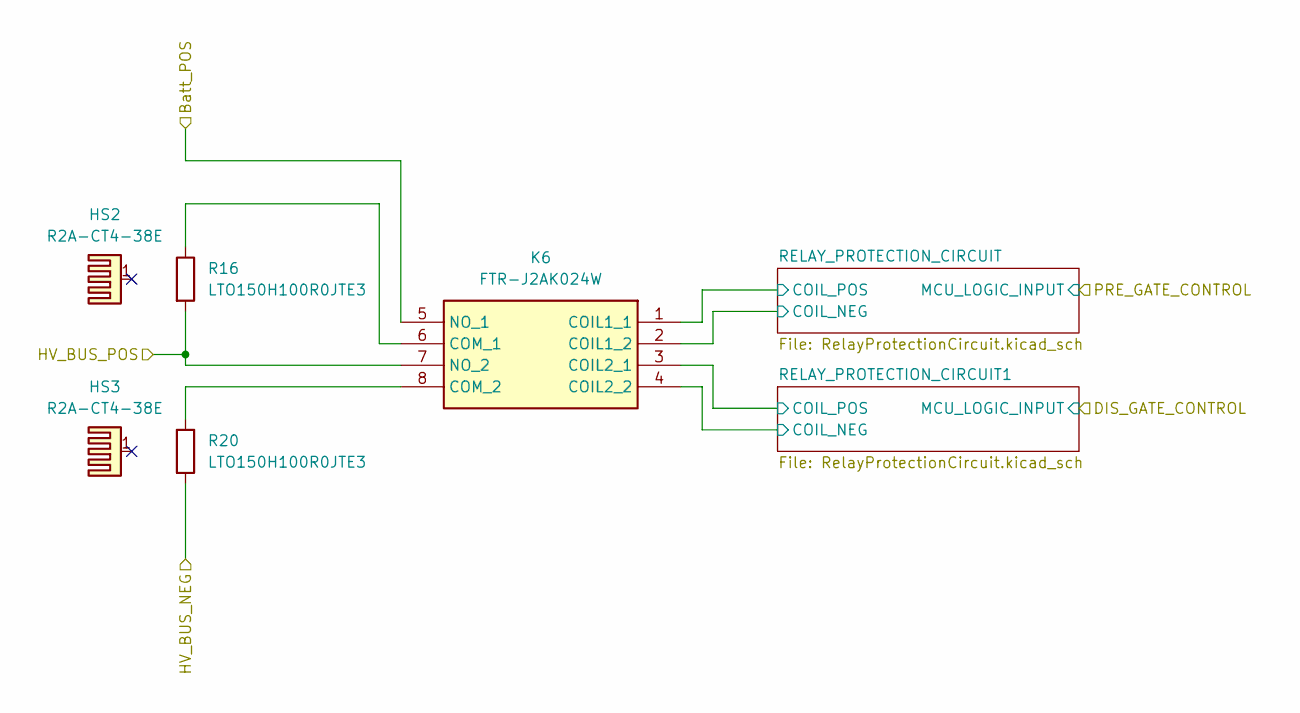
[picture p51: schematic charge_circuits.kicad_sch]

Parts:
HS2, HS3: R2A-CT4-38E; DigiKey_Part_Number R2A-CT4-38E-ND
K6: FTR-J2AK024W; FTRJ2AK012W; Mouser Part Number 817-FTR-J2AK012W
R16, R20: LTO150H100R0JTE3; TO-247-2_Vertical; DigiKey_Part_Number 716-LTO150H100R0JTE3-ND

Connections:
+24V: K6.1 (COIL1_1), K6.3 (COIL2_1); also elsewhere on the board
/HV_BUS_NEG: R20.2; also elsewhere on the board
/Pre & Dis Charge/Batt_POS: K6.5 (NO_1); also elsewhere on the board
/Pre & Dis Charge/HV_BUS_POS: K6.7 (NO_2), R16.2; also elsewhere on the board
/Pre & Dis Charge/RELAY_PROTECTION_CIRCUIT1/COIL_NEG: K6.4 (COIL2_2); also elsewhere on the board
/Pre & Dis Charge/RELAY_PROTECTION_CIRCUIT/COIL_NEG: K6.2 (COIL1_2); also elsewhere on the board
unnamed: K6.6 (COM_1), R16.1
unnamed: K6.8 (COM_2), R20.1

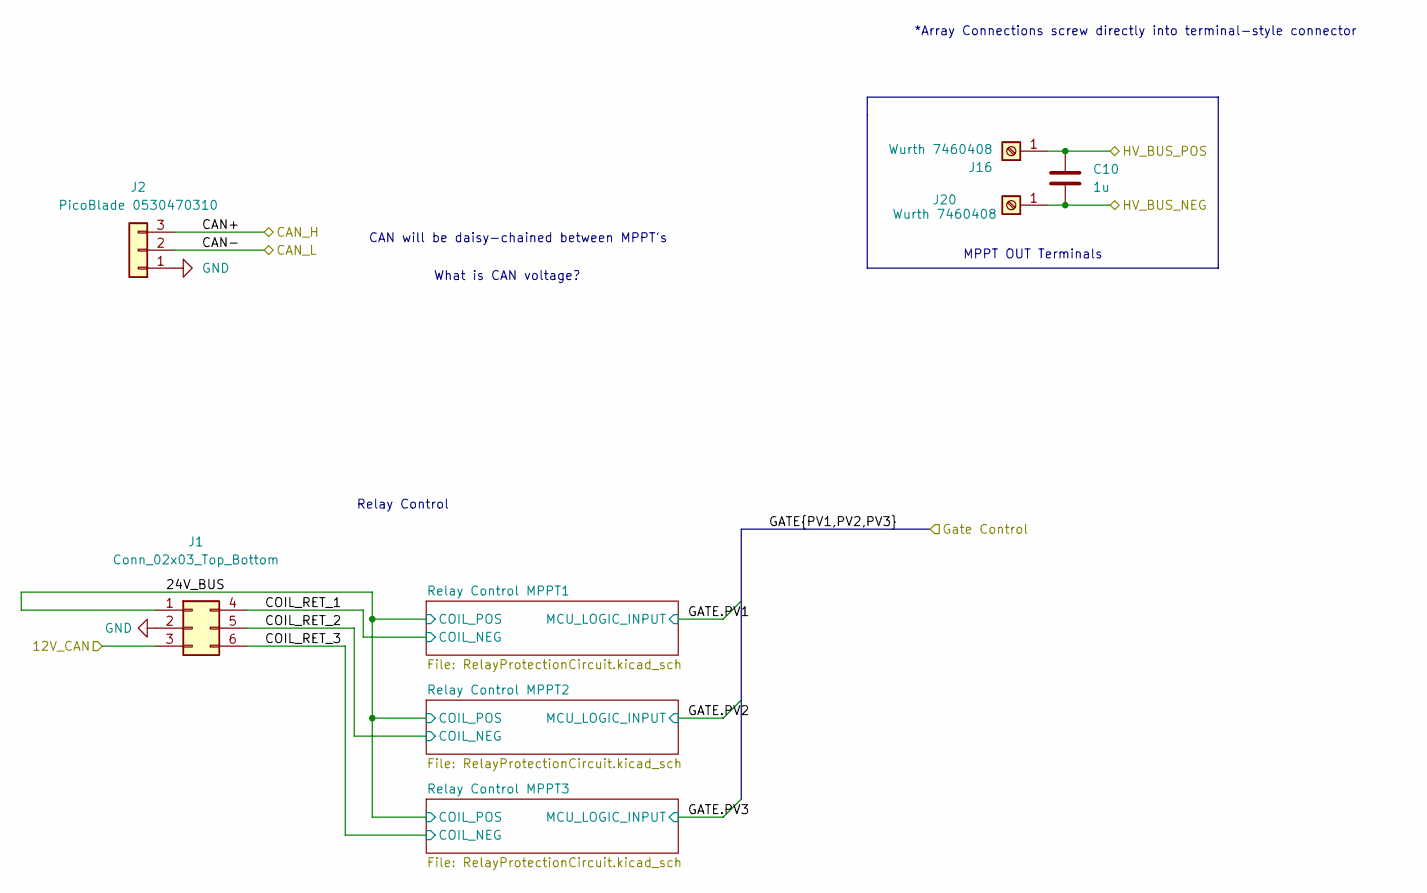
[picture p52: schematic elmar_racing_mppt.kicad_sch]

Parts:
C10: 1u; C_1812_4532Metric; LCSC C3037685
J1: Conn_02x03_Top_Bottom; Molex_Mini-Fit_Jr_5566-06A_2x03_P4.20mm_Vertical; DigiKey_Part_Number WM3802-ND
J2: PicoBlade 0530470310; Molex_PicoBlade_53047-0310_1x03_P1.25mm_Vertical; DigiKey_Part_Number WM1732-ND
J16, J20: Wurth 7460408; MP_Wurth_WP-BUCF_7460408; DigiKey_Part_Number 732-7460408-ND

Connections:
+24V: J1.1; also elsewhere on the board
/24 Supplementary Switch/12V_CAN: J1.3; also elsewhere on the board
/CAN+: J2.3; also elsewhere on the board
/CAN-: J2.2; also elsewhere on the board
/Elmar Racing MPPTS/COIL_RET_1: J1.4; also elsewhere on the board
/Elmar Racing MPPTS/COIL_RET_2: J1.5; also elsewhere on the board
/Elmar Racing MPPTS/COIL_RET_3: J1.6; also elsewhere on the board
/Elmar Racing MPPTS/HV_BUS_NEG: C10.2, J20.1 (Pin_1_1); also elsewhere on the board
/HV_BUS_POS: C10.1, J16.1 (Pin_1_1); also elsewhere on the board
GND: J1.2, J2.1; also elsewhere on the board

Notes on the sheet:
CAN will be daisy-chained between MPPT's
*Array Connections screw directly into terminal-style connector
MPPT OUT Terminals
What is CAN voltage?
Relay Control

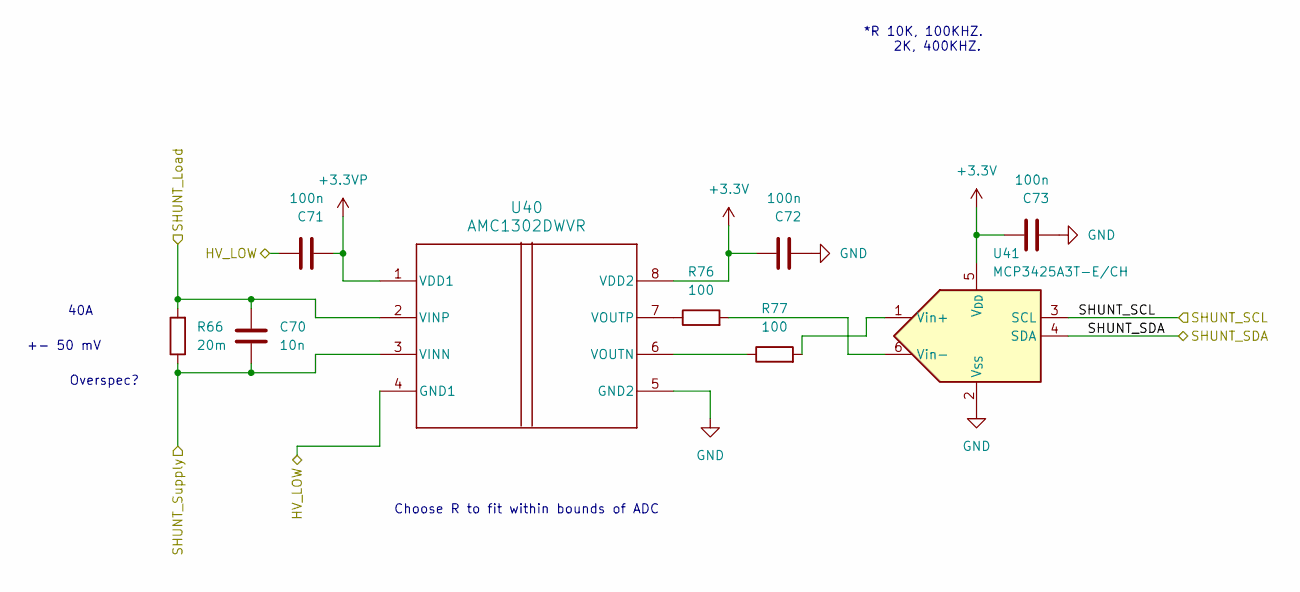
[picture p53: schematic shunt_sensor_circuit_dcdc.kicad_sch]

Parts:
C70: 10n; C_0603_1608Metric_Pad1.08x0.95mm_HandSolder; Rating 50V; LCSC C57112
C71, C72, C73: 100n; C_0603_1608Metric_Pad1.08x0.95mm_HandSolder; Rating 50V; LCSC C14663
R66: 20m; D_2512_6332Metric; Rating 200V; LCSC C845325
R76, R77: 100; R_0603_1608Metric_Pad0.98x0.95mm_HandSolder; Rating 75V; LCSC C22775
U40: AMC1302DWVR; DWV0008A; LCSC C2863209
U41: MCP3425A3T-E/CH; SOT-23-6; DigiKey_Part_Number 150-MCP3425A3T-E/CHDKR-ND

Connections:
+3.3V: C72.1, C73.1, U40.8 (VDD2), U41.5 (V_{DD}); also elsewhere on the board
+3.3VP: C71.2, U40.1 (VDD1); also elsewhere on the board
/<NO NET>: U41.3 (SCL); also elsewhere on the board
/HV_BUS_NEG: C70.1, C71.1, R66.2, U40.2 (VINP), U40.4 (GND1); also elsewhere on the board
/LV DCDC Current Sense/SHUNT_Supply: C70.2, R66.1, U40.3 (VINN); also elsewhere on the board
/SDA: U41.4 (SDA); also elsewhere on the board
GND: C72.2, C73.2, U40.5 (GND2), U41.2 (V_{SS}); also elsewhere on the board
unnamed: R77.1, U40.6 (VOUTN)
unnamed: R76.1, U40.7 (VOUTP)
unnamed: R77.2, U41.1 (Vin+)
unnamed: R76.2, U41.6 (Vin-)

Notes on the sheet:
Overspec?
40A
*R 10K, 100KHZ. 2K, 400KHZ.
Choose R to fit within bounds of ADC
+- 50 mV
