Rutherfurrd/Sakura-1---High-Voltage-Power-Distribution-System/Power Distribution Board/BatteryBoard.kicad_pcb

## KiCad design Power Distribution Board/BatteryBoard.kicad_pcb (continued)

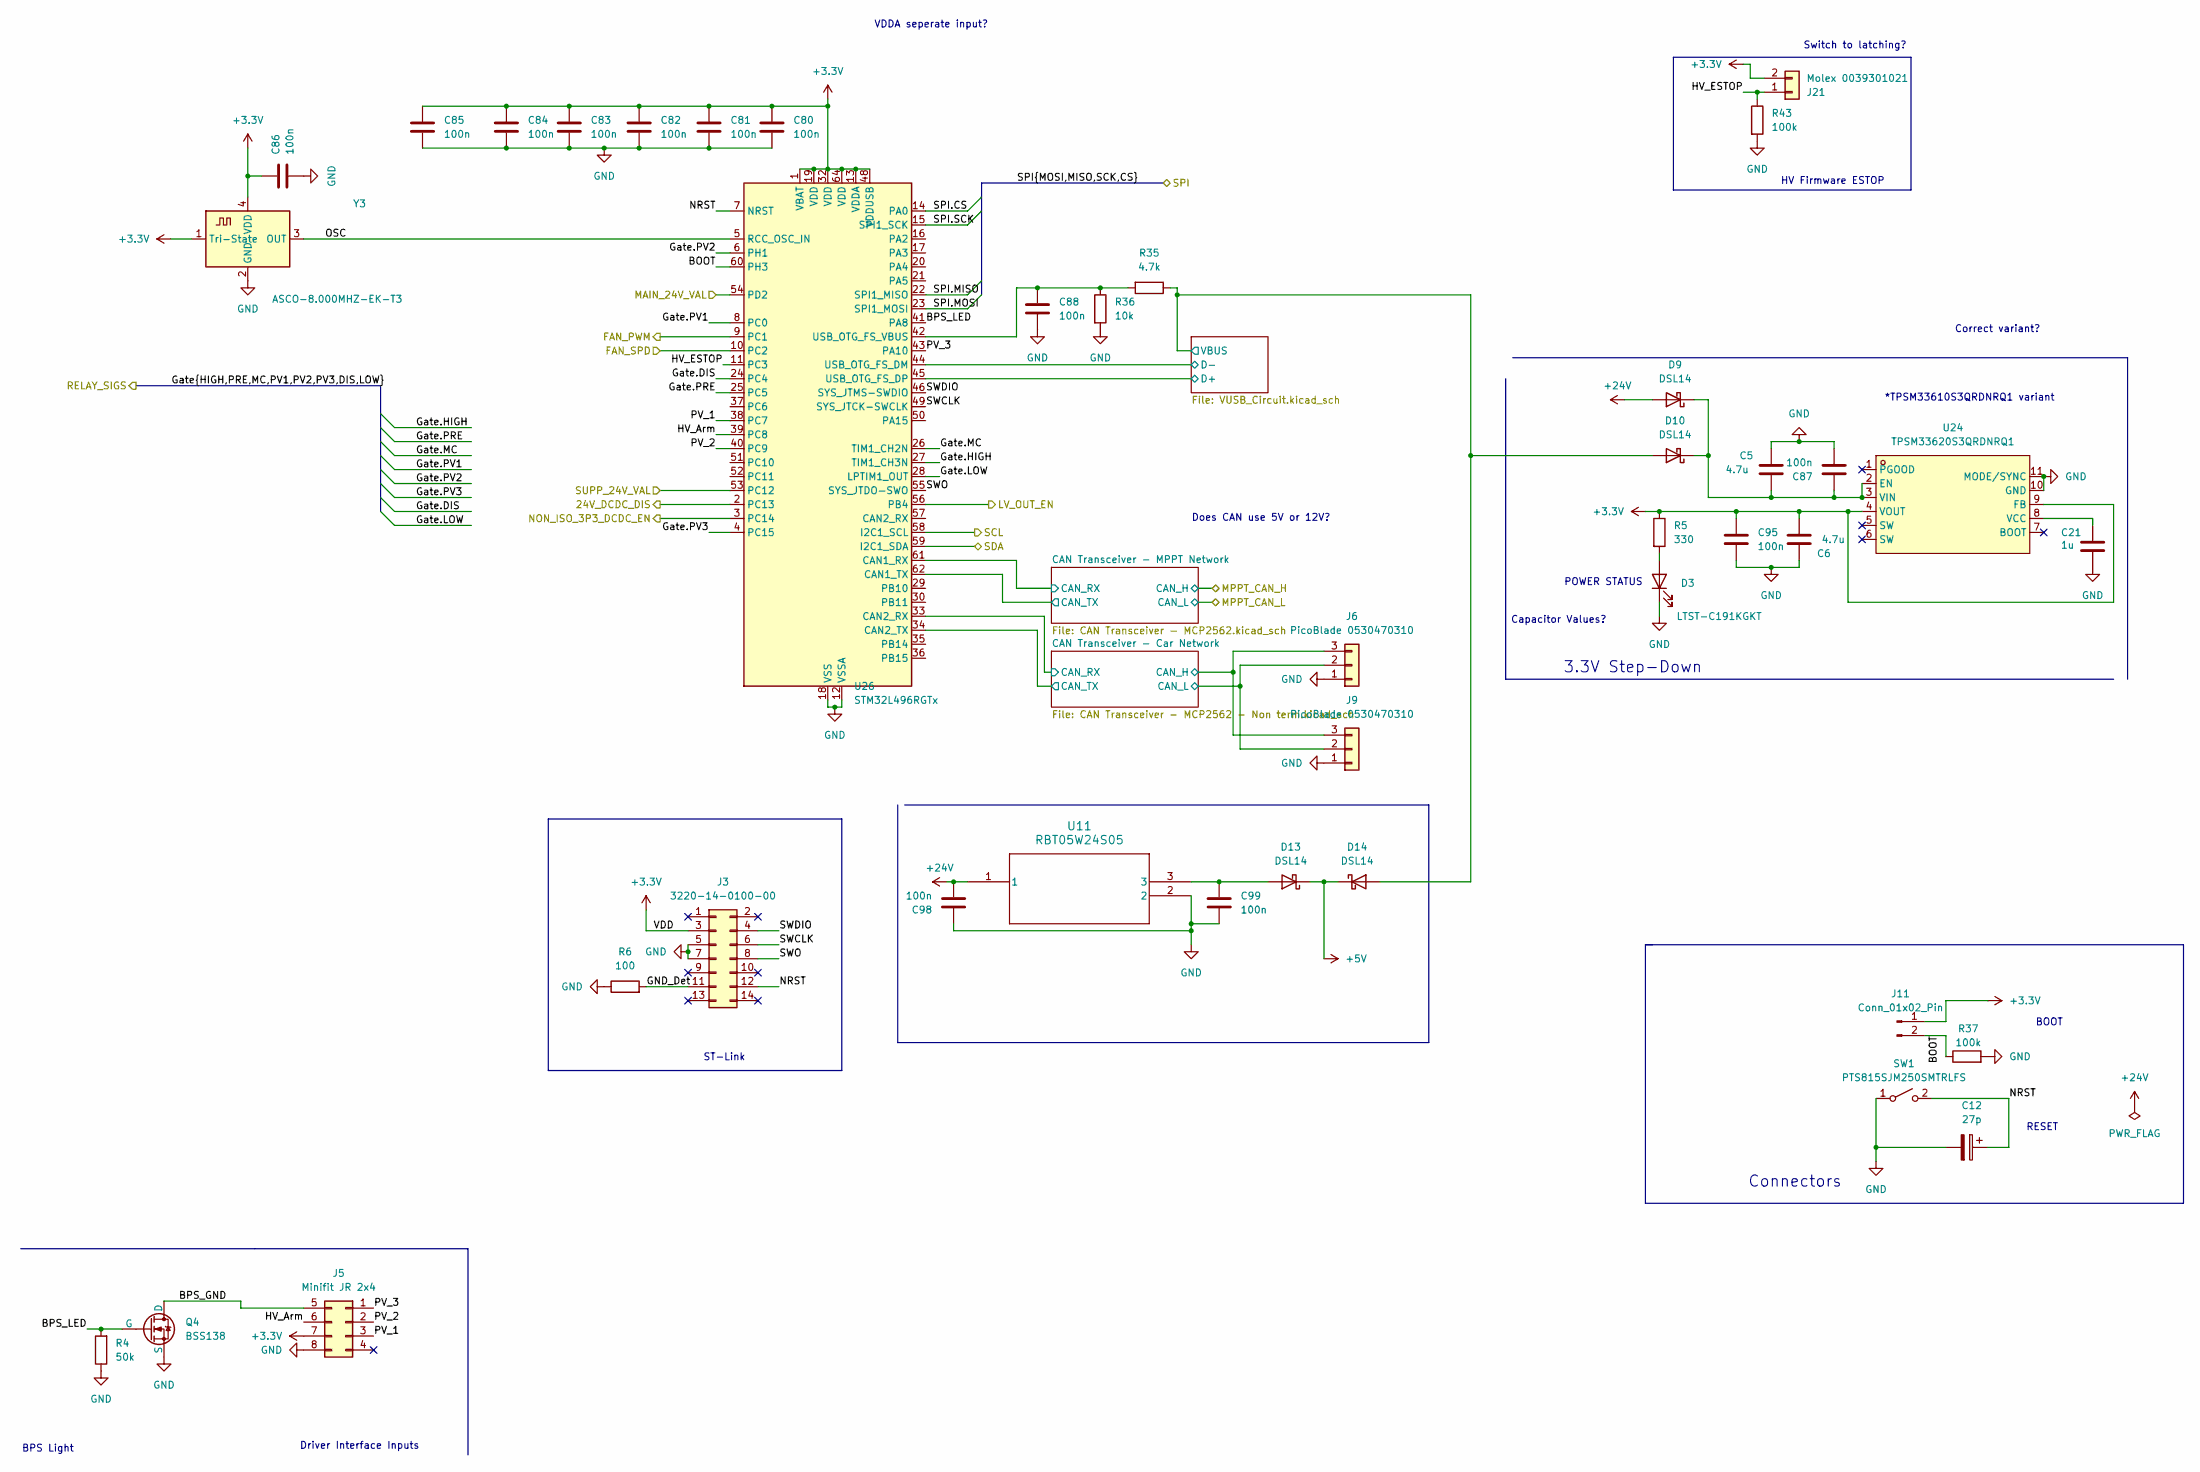
[picture p54: schematic stm32_control.kicad_sch]

Parts:
C5, C6: 4.7u; C_0603_1608Metric_Pad1.08x0.95mm_HandSolder; Rating 50V; LCSC C19666
C12: 27p; C_0603_1608Metric_Pad1.08x0.95mm_HandSolder; LCSC C107045
C21: 1u; C_0603_1608Metric_Pad1.08x0.95mm_HandSolder; LCSC C15849
C80, C81, C82, C83, C84, C85, C86, C87, C88, C95, C98, C99: 100n; C_0603_1608Metric_Pad1.08x0.95mm_HandSolder; Rating 50V; LCSC C14663
D3: LTST-C191KGKT; LED_0603_1608Metric_Pad1.05x0.95mm_HandSolder; DigiKey_Part_Number 160-1446-1-ND
D9, D10, D13, D14: DSL14; D_SOD-123FL; LCSC C22466349
J3: 3220-14-0100-00; PinHeader_2x07_P1.27mm_Vertical_SMD; DigiKey_Part_Number SAM13170CT-ND
J5: Minifit JR 2x4; Molex_Mini-Fit_Jr_5566-08A_2x04_P4.20mm_Vertical; DigiKey_Part_Number WM3846-ND
J6, J9: PicoBlade 0530470310; Molex_PicoBlade_53047-0310_1x03_P1.25mm_Vertical; DigiKey_Part_Number WM1732-ND
J11: Conn_01x02_Pin; HARWIN_M20-9990246; DigiKey_Part_Number 952-2262-ND
J21: Molex 0039301021; Molex_Mini-Fit_Jr_5566-02A_2x01_P4.20mm_Vertical; DigiKey_Part_Number WM3843-ND
Q4: BSS138; SOT-23; LCSC C7420339
R4: 50k; R_0603_1608Metric_Pad0.98x0.95mm_HandSolder; LCSC C23184
R5: 330; R_0603_1608Metric_Pad0.98x0.95mm_HandSolder; LCSC C23138
R6: 100; R_0603_1608Metric_Pad0.98x0.95mm_HandSolder; LCSC C22775
R35: 4.7k; R_0603_1608Metric_Pad0.98x0.95mm_HandSolder; LCSC C23162
R36: 10k; R_0603_1608Metric_Pad0.98x0.95mm_HandSolder; LCSC C95204
R37, R43: 100k; R_0603_1608Metric_Pad0.98x0.95mm_HandSolder; LCSC C25803
SW1: PTS815SJM250SMTRLFS; SW_SPST_PTS810; DigiKey_Part_Number CKN12215-2-ND
U11: RBT05W24S05; RBT10W24S05_XPP_XPR; DigiKey_Part_Number 1470-RBT05W24S05-ND
U24: TPSM33620S3QRDNRQ1; QFN-11_L4.5-W3.5-P0.50-TL_TPSM365R6FRDNR; MPN TPSM33620S3QRDNRQ1; LCSC C49261907
U26: STM32L496RGTx; LQFP-64_10x10mm_P0.5mm; LCSC C124720
Y3: ASCO-8.000MHZ-EK-T3; Oscillator_SMD_Abracon_ASCO-4Pin_1.6x1.2mm; DigiKey_Part_Number 535-12077-1-ND

Connections:
+3.3V: C6.1, C80.1, C81.1, C82.1, C83.1, C84.1, C85.1, C86.1, C95.1, J3.3, J5.7, J11.1, J21.2, R5.1, U24.4 (VOUT), U24.9 (FB), U26.1 (VBAT), U26.13 (VDDA), U26.19 (VDD), U26.32 (VDD), U26.48 (VDDUSB), U26.64 (VDD), Y3.1 (Tri-State), Y3.4 (VDD); also elsewhere on the board
+5V: D13.1 (K), D14.1 (K); also elsewhere on the board
+24V: C98.2, D9.2 (A), U11.1; also elsewhere on the board
/24 Supplementary Switch/LV_OUT_EN: U26.56 (PB4); also elsewhere on the board
/24 Supplementary Switch/MAIN_24V_VALID: U26.53 (PC12); also elsewhere on the board
/24 Supplementary Switch/SUPP_24V_VALID: U26.54 (PD2); also elsewhere on the board
/<NO NET>: U26.58 (I2C1_SCL); also elsewhere on the board
/Battery Fan/FAN1_SPD: U26.10 (PC2); also elsewhere on the board
/Battery Fan/FAN_PWM: U26.9 (PC1); also elsewhere on the board
/Gate.DIS: U26.24 (PC4); also elsewhere on the board
/Gate.HIGH: U26.27 (TIM1_CH3N); also elsewhere on the board
/Gate.LOW: U26.28 (LPTIM1_OUT); also elsewhere on the board
/Gate.MC: U26.26 (TIM1_CH2N); also elsewhere on the board
/Gate.PRE: U26.25 (PC5); also elsewhere on the board
/Gate.PV1: U26.8 (PC0); also elsewhere on the board
/Gate.PV2: U26.6 (PH1); also elsewhere on the board
/Gate.PV3: U26.4 (PC15); also elsewhere on the board
/LV Step-down/24V_CONV_EN_ACTIVELOW: U26.2 (PC13); also elsewhere on the board
/LV Step-down/NON_ISO_3P3_EN: U26.3 (PC14); also elsewhere on the board
/SDA: U26.59 (I2C1_SDA); also elsewhere on the board
/SPI.CS: U26.14 (PA0); also elsewhere on the board
/SPI.MISO: U26.22 (SPI1_MISO); also elsewhere on the board
/SPI.MOSI: U26.23 (SPI1_MOSI); also elsewhere on the board
/SPI.SCK: U26.15 (SPI1_SCK); also elsewhere on the board
/STM32_CONTROL/BOOT: J11.2, R37.1, U26.60 (PH3)
/STM32_CONTROL/BPS_GND: J5.5, Q4.1 (D)
/STM32_CONTROL/BPS_LED: Q4.2 (G), R4.2, U26.41 (PA8)
/STM32_CONTROL/CAN Transceiver - Car Network/CAN+: J6.3, J9.3; also elsewhere on the board
/STM32_CONTROL/CAN Transceiver - Car Network/CAN-: J6.2, J9.2; also elsewhere on the board
/STM32_CONTROL/CAN Transceiver - Car Network/CAN_RX: U26.33 (CAN2_RX); also elsewhere on the board
/STM32_CONTROL/CAN Transceiver - Car Network/CAN_TX: U26.34 (CAN2_TX); also elsewhere on the board
/STM32_CONTROL/CAN Transceiver - MPPT Network/CAN_RX: U26.61 (CAN1_RX); also elsewhere on the board
/STM32_CONTROL/CAN Transceiver - MPPT Network/CAN_TX: U26.62 (CAN1_TX); also elsewhere on the board
/STM32_CONTROL/GND_Det: J3.11, R6.2
/STM32_CONTROL/HV_Arm: J5.6, U26.39 (PC8)
/STM32_CONTROL/HV_ESTOP: J21.1, R43.1, U26.11 (PC3)
/STM32_CONTROL/NRST: C12.1, J3.12, SW1.2 (B), U26.7 (NRST)
/STM32_CONTROL/OSC: U26.5 (RCC_OSC_IN), Y3.3 (OUT)
/STM32_CONTROL/PV_1: J5.3, U26.38 (PC7)
/STM32_CONTROL/PV_2: J5.2, U26.40 (PC9)
/STM32_CONTROL/PV_3: J5.1, U26.43 (PA10)
/STM32_CONTROL/SWCLK: J3.6, U26.49 (SYS_JTCK-SWCLK)
/STM32_CONTROL/SWDIO: J3.4, U26.46 (SYS_JTMS-SWDIO)
/STM32_CONTROL/SWO: J3.8, U26.55 (SYS_JTDO-SWO)
/STM32_CONTROL/USC_CIRCUIT/D+: U26.45 (USB_OTG_FS_DP); also elsewhere on the board
/STM32_CONTROL/USC_CIRCUIT/D-: U26.44 (USB_OTG_FS_DM); also elsewhere on the board
/STM32_CONTROL/USC_CIRCUIT/VBUS: D10.2 (A), D14.2 (A), R35.1; also elsewhere on the board
GND: C5.2, C6.2, C12.2, C21.1, C80.2, C81.2, C82.2, C83.2, C84.2, C85.2, C86.2, C87.2, C88.2, C95.2, C98.1, C99.2, D3.1 (K), J3.5, J3.7, J5.8, J6.1, J9.1, Q4.3 (S), R4.1, R6.1, R36.2, R37.2, R43.2, SW1.1 (A), U11.2, U24.10 (GND), U24.11 (MODE/SYNC), U26.12 (VSSA), U26.18 (VSS), U26.31 (VSS), U26.47 (VSS), U26.63 (VSS), Y3.2 (GND); also elsewhere on the board
unnamed: D3.2 (A), R5.2
unnamed: C5.1, C87.1, D9.1 (K), D10.1 (K), U24.2 (EN), U24.3 (VIN)
unnamed: C99.1, D13.2 (A), U11.3
unnamed: C21.2, U24.8 (VCC)
unnamed: C88.1, R35.2, R36.1, U26.42 (USB_OTG_FS_VBUS)

Notes on the sheet:
HV Firmware ESTOP
Does CAN use 5V or 12V?
Capacitor Values?
*TPSM33610S3QRDNRQ1 variant
Driver Interface Inputs
BPS Light
Correct variant?
Connectors
3.3V Step-Down
ST-Link
BOOT
Switch to latching?
RESET
VDDA seperate input?
POWER STATUS

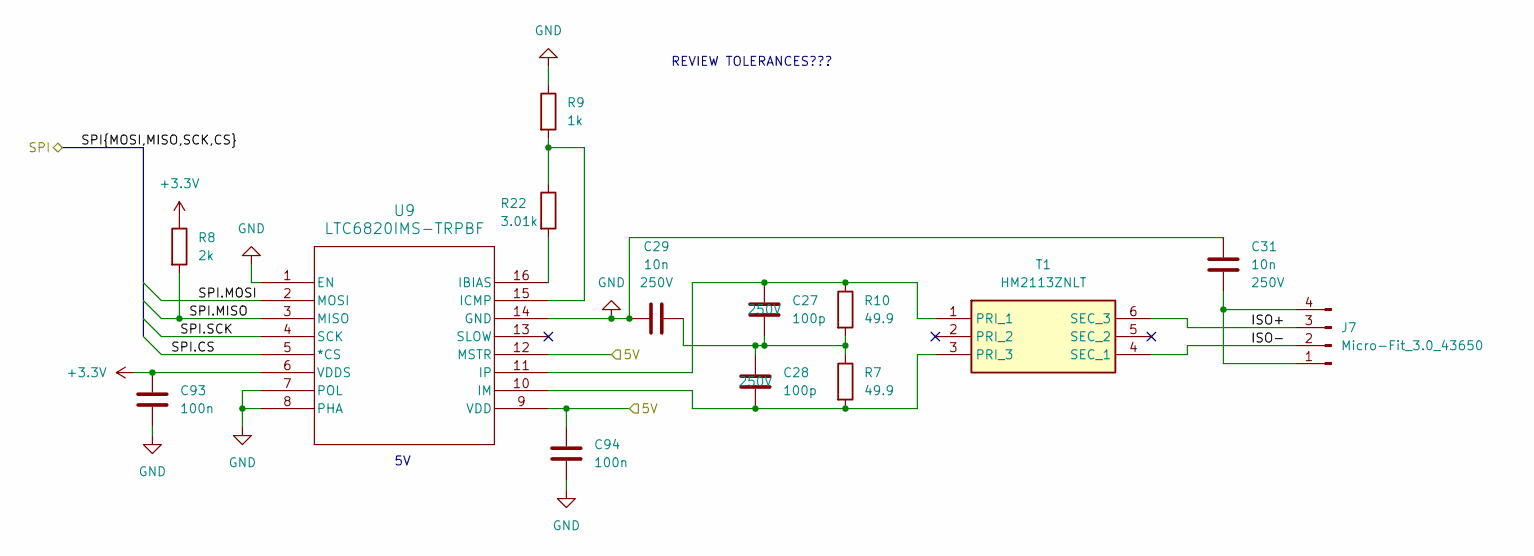
[picture p55: schematic isospi.kicad_sch]

Parts:
C27, C28: 100p; C_0603_1608Metric_Pad1.08x0.95mm_HandSolder; LCSC C14858
C29, C31: 10n; C_0603_1608Metric_Pad1.08x0.95mm_HandSolder; LCSC C57112
C93, C94: 100n; C_0603_1608Metric_Pad1.08x0.95mm_HandSolder; Rating 50V; LCSC C14663
J7: Micro-Fit_3.0_43650; Molex_Micro-Fit_3.0_43650-0415_1x04_P3.00mm_Vertical; DigiKey_Part_Number WM1919-ND
R7, R10: 49.9; R_0603_1608Metric_Pad0.98x0.95mm_HandSolder; LCSC C23185
R8: 2k; R_0603_1608Metric_Pad0.98x0.95mm_HandSolder; LCSC C22975
R9: 1k; R_0603_1608Metric_Pad0.98x0.95mm_HandSolder; LCSC C21190
R22: 3.01k; R_0603_1608Metric_Pad0.98x0.95mm_HandSolder; LCSC C22991
T1: HM2113ZNLT; Mouser Part Number 673-HM2113ZNLT
U9: LTC6820IMS-TRPBF; MS_05-08-1669_ADI; LCSC C581009

Connections:
+3.3V: C93.1, R8.1, U9.6 (VDDS); also elsewhere on the board
+5V: C94.1, U9.9 (VDD), U9.12 (MSTR); also elsewhere on the board
/ISOSPI/ISO+: J7.3, T1.6 (SEC_3)
/ISOSPI/ISO-: J7.2, T1.4 (SEC_1)
/SPI.CS: U9.5 (*CS); also elsewhere on the board
/SPI.MISO: R8.2, U9.3 (MISO); also elsewhere on the board
/SPI.MOSI: U9.2 (MOSI); also elsewhere on the board
/SPI.SCK: U9.4 (SCK); also elsewhere on the board
GND: C29.1, C31.2, C93.2, C94.2, R9.1, U9.1 (EN), U9.7 (POL), U9.8 (PHA), U9.14 (GND); also elsewhere on the board
unnamed: C27.2, C28.1, C29.2, R7.1, R10.2
unnamed: C31.1, J7.1, J7.4
unnamed: C27.1, R10.1, T1.1 (PRI_1), U9.11 (IP)
unnamed: C28.2, R7.2, T1.3 (PRI_3), U9.10 (IM)
unnamed: R22.2, U9.16 (IBIAS)
unnamed: R9.2, R22.1, U9.15 (ICMP)

Notes on the sheet:
REVIEW TOLERANCES???

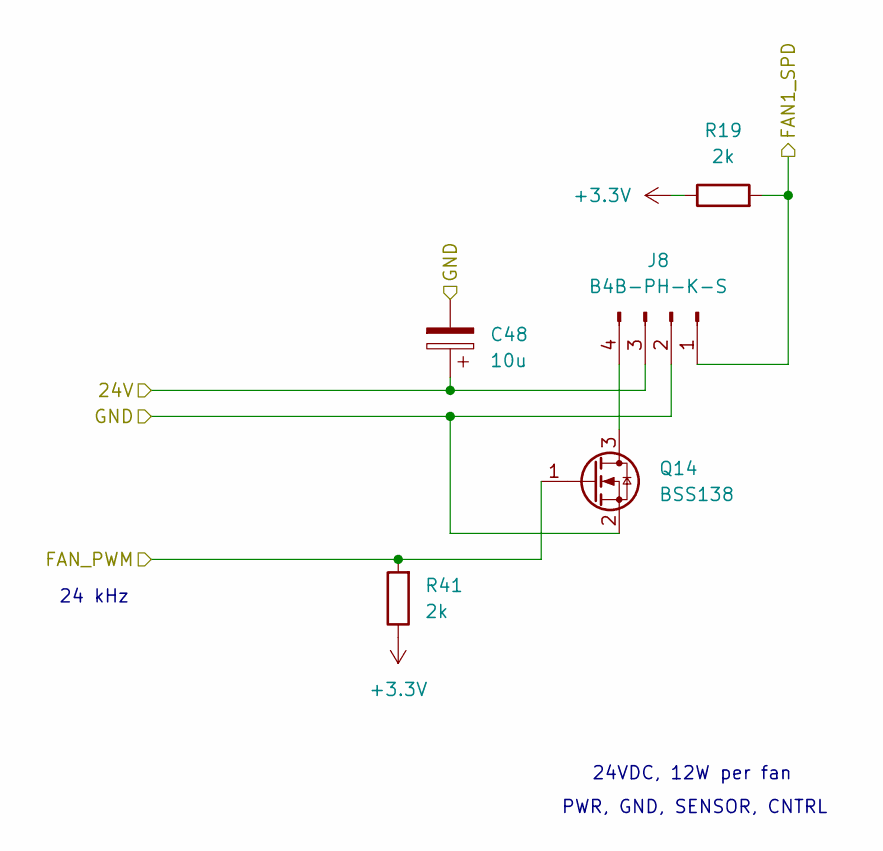
[picture p56: schematic batt_fan.kicad_sch]

Parts:
C48: 10u; CP_Radial_D10.0mm_P5.00mm; DigiKey_Part_Number 450BXC10MEFC10X20
J8: B4B-PH-K-S; JST_PH_B4B-PH-K_1x04_P2.00mm_Vertical; DigiKey_Part_Number N/A
Q14: BSS138; SOT-23; LCSC C7420339
R19, R41: 2k; R_0603_1608Metric_Pad0.98x0.95mm_HandSolder; LCSC C22975

Connections:
+3.3V: R19.1, R41.1; also elsewhere on the board
+24V: C48.1, J8.3; also elsewhere on the board
/Battery Fan/FAN1_SPD: J8.1, R19.2; also elsewhere on the board
/Battery Fan/FAN_PWM: Q14.1 (G), R41.2; also elsewhere on the board
GND: C48.2, J8.2, Q14.2 (S); also elsewhere on the board
unnamed: J8.4, Q14.3 (D)

Notes on the sheet:
PWR, GND, SENSOR, CNTRL
24 kHz
24VDC, 12W per fan

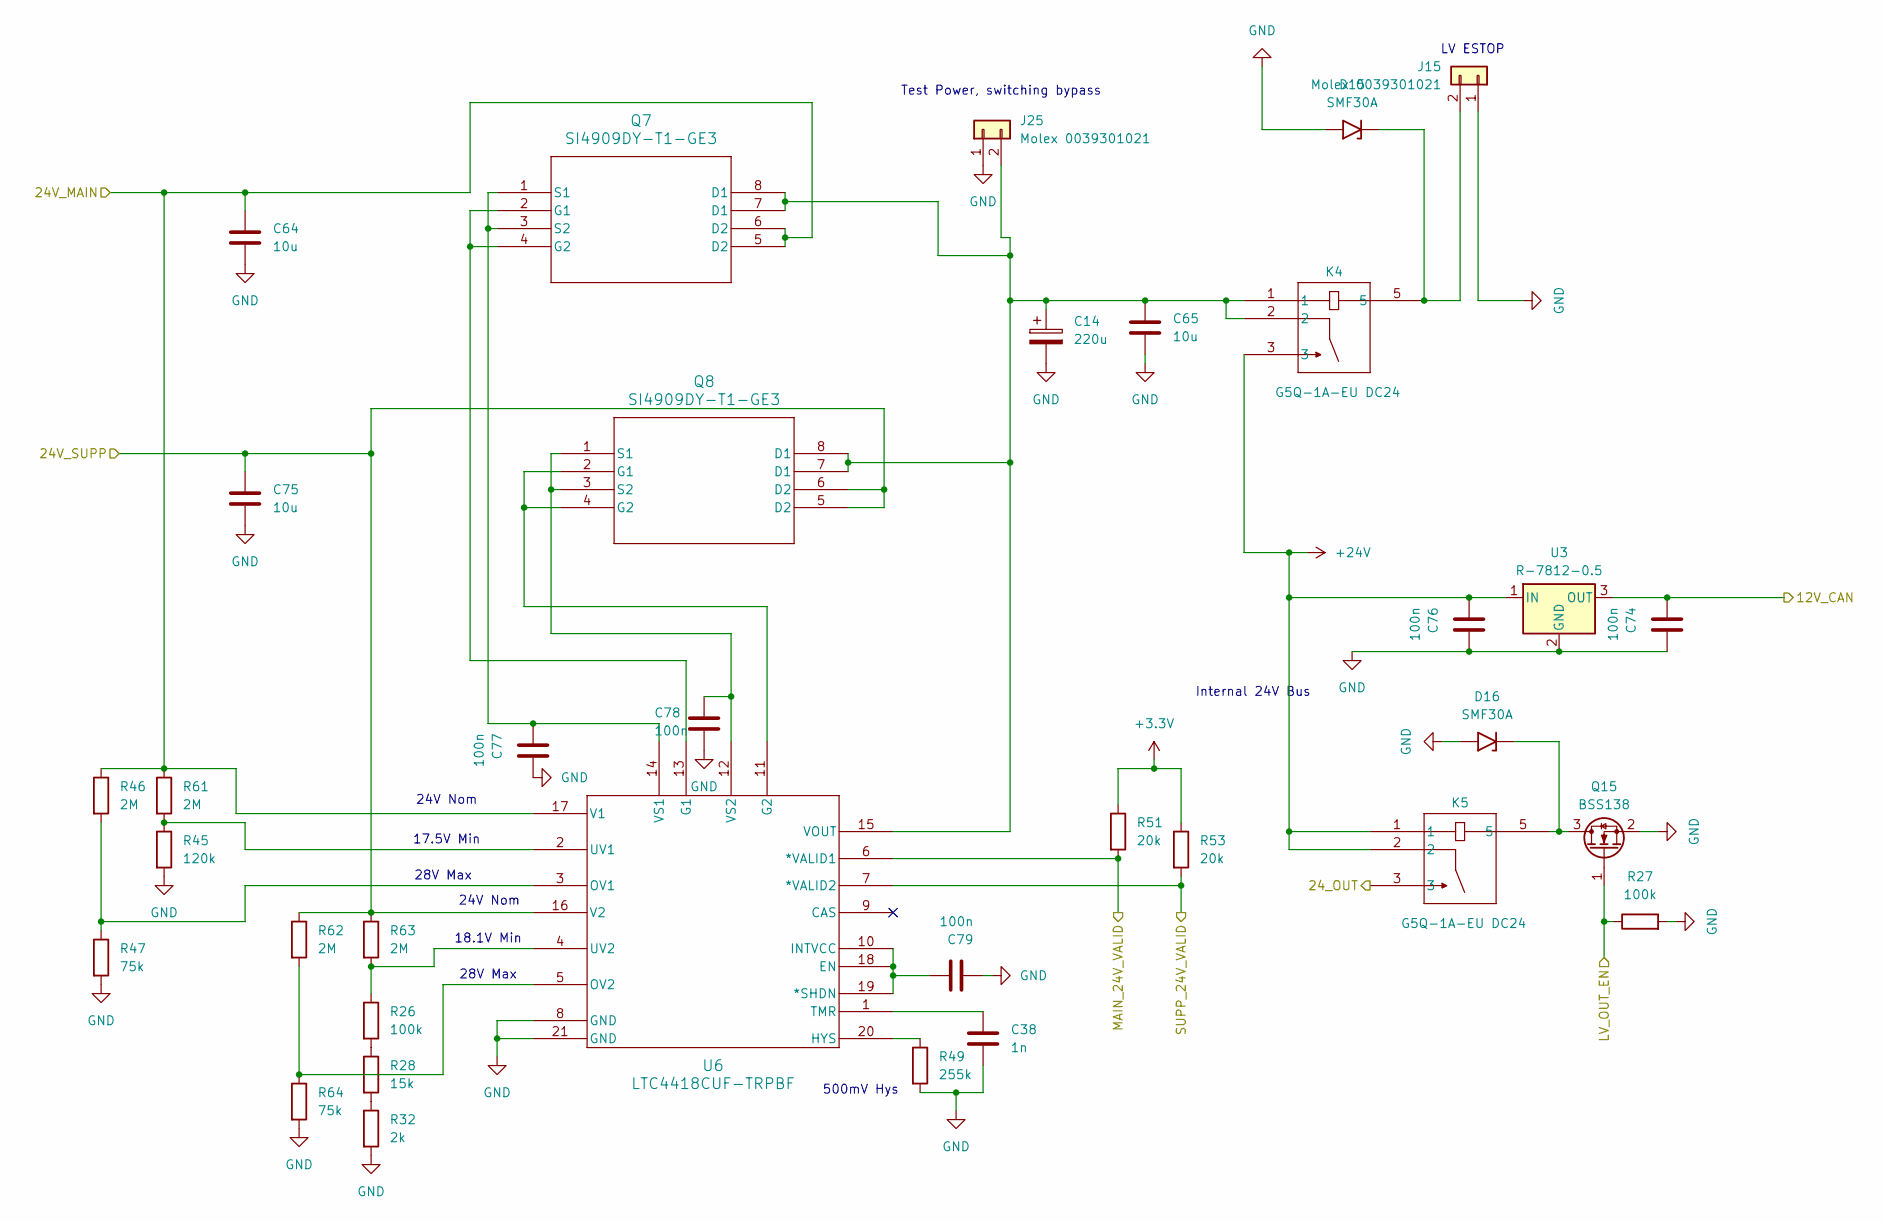
[picture p57: schematic supp.kicad_sch]

Parts:
C14: 220u; CP_Radial_D10.0mm_P5.00mm; DigiKey_Part_Number CAP ALUM 220UF 20% 50V RADIAL TH
C38: 1n; C_0603_1608Metric_Pad1.08x0.95mm_HandSolder; LCSC C1588
C64, C65, C75: 10u; C_1206_3216Metric_Pad1.33x1.80mm_HandSolder; LCSC C13585
C74, C76, C77, C78, C79: 100n; C_0603_1608Metric_Pad1.08x0.95mm_HandSolder; Rating 50V; LCSC C14663
D15, D16: SMF30A; D_SMF; LCSC C19077518
J15, J25: Molex 0039301021; Molex_Mini-Fit_Jr_5566-02A_2x01_P4.20mm_Vertical; DigiKey_Part_Number WM3843-ND
K4, K5: G5Q-1A-EU DC24; Relay_SPST_Omron-G5Q-1A; Rating Z5361-ND
Q7, Q8: SI4909DY-T1-GE3; SOIC_09DY-T1-GE3_VIS; LCSC C222523
Q15: BSS138; SOT-23; LCSC C7420339
R26, R27: 100k; R_0603_1608Metric_Pad0.98x0.95mm_HandSolder; LCSC C25803
R28: 15k; R_0603_1608Metric_Pad0.98x0.95mm_HandSolder; LCSC C22809
R32: 2k; R_0603_1608Metric_Pad0.98x0.95mm_HandSolder; LCSC C22975
R45: 120k; R_0603_1608Metric_Pad0.98x0.95mm_HandSolder; LCSC C25808
R46, R61, R62, R63: 2M; R_0603_1608Metric_Pad0.98x0.95mm_HandSolder; LCSC C22976
R47, R64: 75k; R_0603_1608Metric_Pad0.98x0.95mm_HandSolder; LCSC C23242
R49: 255k; R_0805_2012Metric_Pad1.20x1.40mm_HandSolder; LCSC C17578
R51, R53: 20k; R_0603_1608Metric_Pad0.98x0.95mm_HandSolder; LCSC C4184
U3: R-7812-0.5; Converter_DCDC_RECOM_R-78E-0.5_THT; DigiKey_Part_Number 945-1032-ND
U6: LTC4418CUF-TRPBF; UF_20_ADI; LCSC C688512

Connections:
+3.3V: R51.1, R53.1; also elsewhere on the board
+24V: C76.2, K4.3, K5.1, K5.2, U3.1 (IN); also elsewhere on the board
/24 Supplementary Switch/12V_CAN: C74.2, U3.3 (OUT); also elsewhere on the board
/24 Supplementary Switch/24V_MAIN: C64.1, Q7.5 (D2), Q7.6 (D2), R46.1, R61.1, U6.17 (V1); also elsewhere on the board
/24 Supplementary Switch/24V_SUPP: C75.1, Q8.5 (D2), Q8.6 (D2), R62.1, R63.1, U6.16 (V2); also elsewhere on the board
/24 Supplementary Switch/24_OUT: K5.3; also elsewhere on the board
/24 Supplementary Switch/LV_OUT_EN: Q15.1 (G), R27.1; also elsewhere on the board
/24 Supplementary Switch/MAIN_24V_VALID: R51.2, U6.6 (*VALID1); also elsewhere on the board
/24 Supplementary Switch/SUPP_24V_VALID: R53.2, U6.7 (*VALID2); also elsewhere on the board
GND: C14.2, C38.2, C64.2, C65.2, C74.1, C75.2, C76.1, C77.1, C78.1, C79.2, D15.2 (A2), D16.2 (A2), J15.1, J25.1, Q15.2 (S), R27.2, R32.2, R45.2, R47.2, R49.2, R64.2, U3.2 (GND), U6.8 (GND), U6.21 (GND); also elsewhere on the board
unnamed: D15.1 (A1), J15.2, K4.5
unnamed: D16.1 (A1), K5.5, Q15.3 (D)
unnamed: C14.1, C65.1, J25.2, K4.1, K4.2, Q7.7 (D1), Q7.8 (D1), Q8.7 (D1), Q8.8 (D1), U6.15 (VOUT)
unnamed: Q7.2 (G1), Q7.4 (G2), U6.13 (G1)
unnamed: C77.2, Q7.1 (S1), Q7.3 (S2), U6.14 (VS1)
unnamed: Q8.2 (G1), Q8.4 (G2), U6.11 (G2)
unnamed: C78.2, Q8.1 (S1), Q8.3 (S2), U6.12 (VS2)
unnamed: R26.2, R28.1
unnamed: R28.2, R32.1
unnamed: C79.1, U6.10 (INTVCC), U6.18 (EN), U6.19 (*SHDN)
unnamed: R49.1, U6.20 (HYS)
unnamed: R46.2, R47.1, U6.3 (OV1)
unnamed: R62.2, R64.1, U6.5 (OV2)
unnamed: C38.1, U6.1 (TMR)
unnamed: R45.1, R61.2, U6.2 (UV1)
unnamed: R26.1, R63.2, U6.4 (UV2)

Notes on the sheet:
17.5V Min
28V Max
Internal 24V Bus
LV ESTOP
24V Nom
500mV Hys
18.1V Min
Test Power, switching bypass

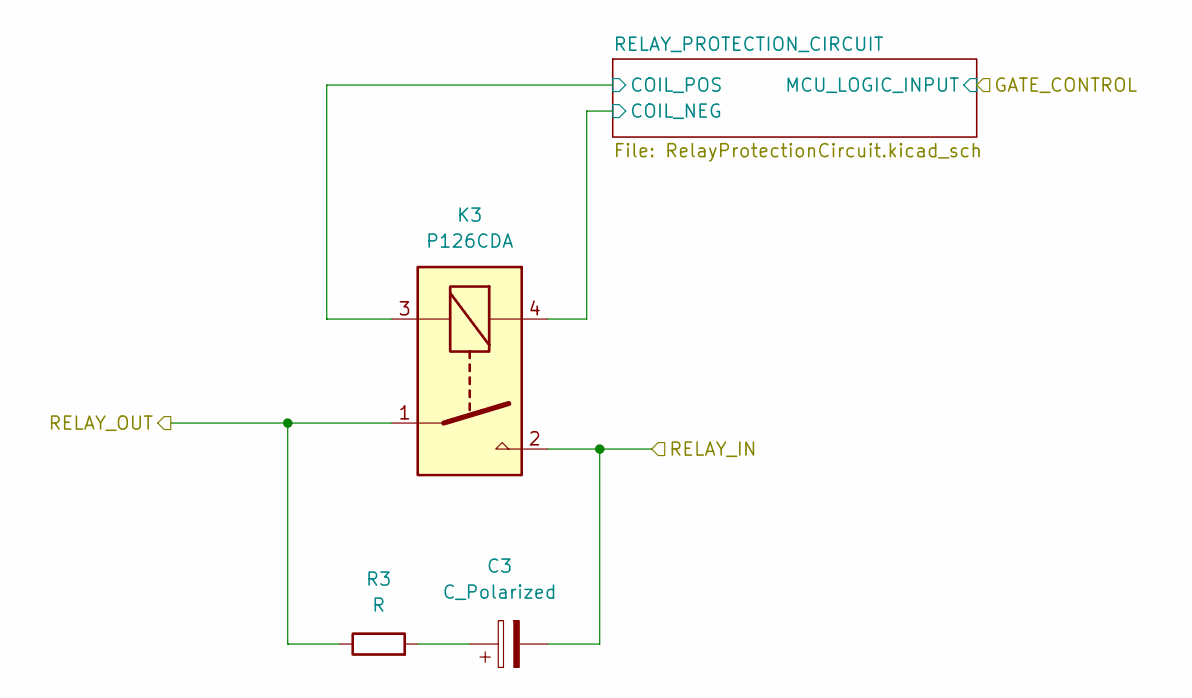
[picture p58: schematic motor_controller_relay.kicad_sch]

Parts:
C3: C_Polarized
K3: P126CDA; DigiKey_Part_Number 3596-P126CDA-ND
R3: R

Connections:
+24V: K3.3; also elsewhere on the board
/MC Relay/RELAY_IN: C3.2, K3.2; also elsewhere on the board
/MC Relay/RELAY_OUT: K3.1, R3.1; also elsewhere on the board
/MC Relay/RELAY_PROTECTION_CIRCUIT/COIL_NEG: K3.4; also elsewhere on the board
unnamed: C3.1, R3.2

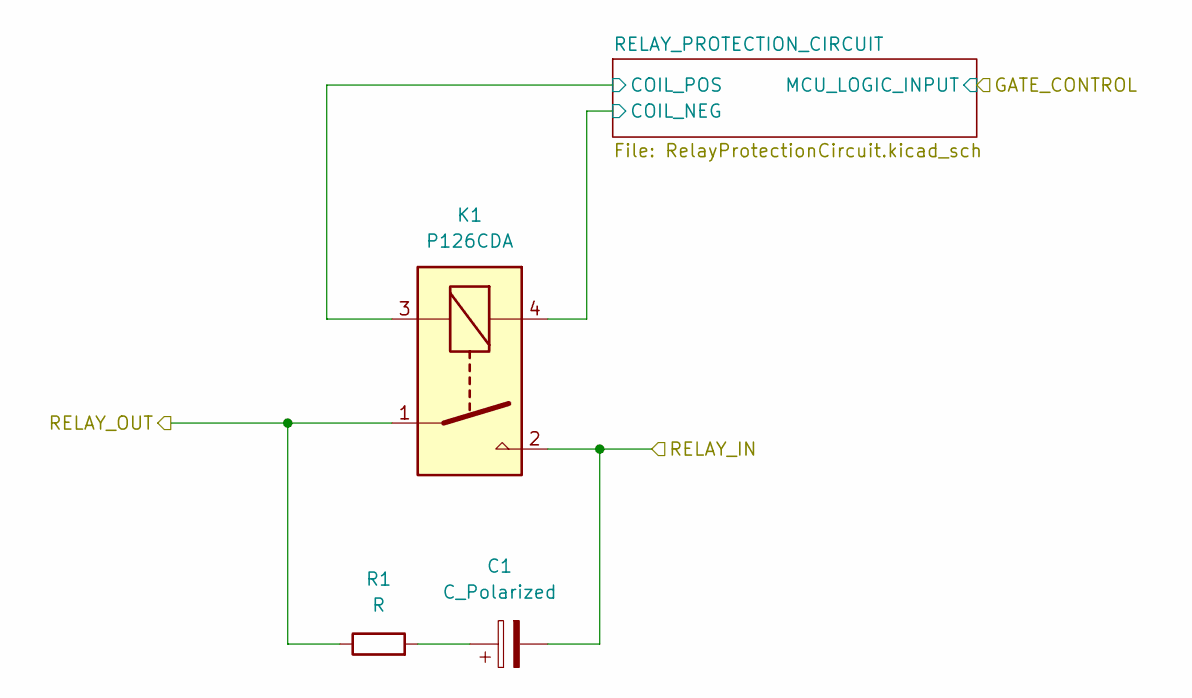
[picture p59: schematic main_contactor.kicad_sch]

Parts:
C1: C_Polarized
K1: P126CDA; DigiKey_Part_Number 3596-P126CDA-ND
R1: R

Connections:
+24V: K1.3; also elsewhere on the board
/HV_BUS_POS: K1.1; also elsewhere on the board
/Main Contactor High/RELAY_IN: K1.2; also elsewhere on the board
/Main Contactor High/RELAY_PROTECTION_CIRCUIT/COIL_NEG: K1.4; also elsewhere on the board
unnamed: C1.1, R1.2

Parts of its further copies:
K2: P126CDA; DigiKey_Part_Number 3596-P126CDA-ND

Connections of its further copies:
+24V: K2.3; also elsewhere on the board
-BATT: K2.1; also elsewhere on the board
/Main Contactor Low/RELAY_IN: K2.2; also elsewhere on the board
/Main Contactor Low/RELAY_PROTECTION_CIRCUIT/COIL_NEG: K2.4; also elsewhere on the board

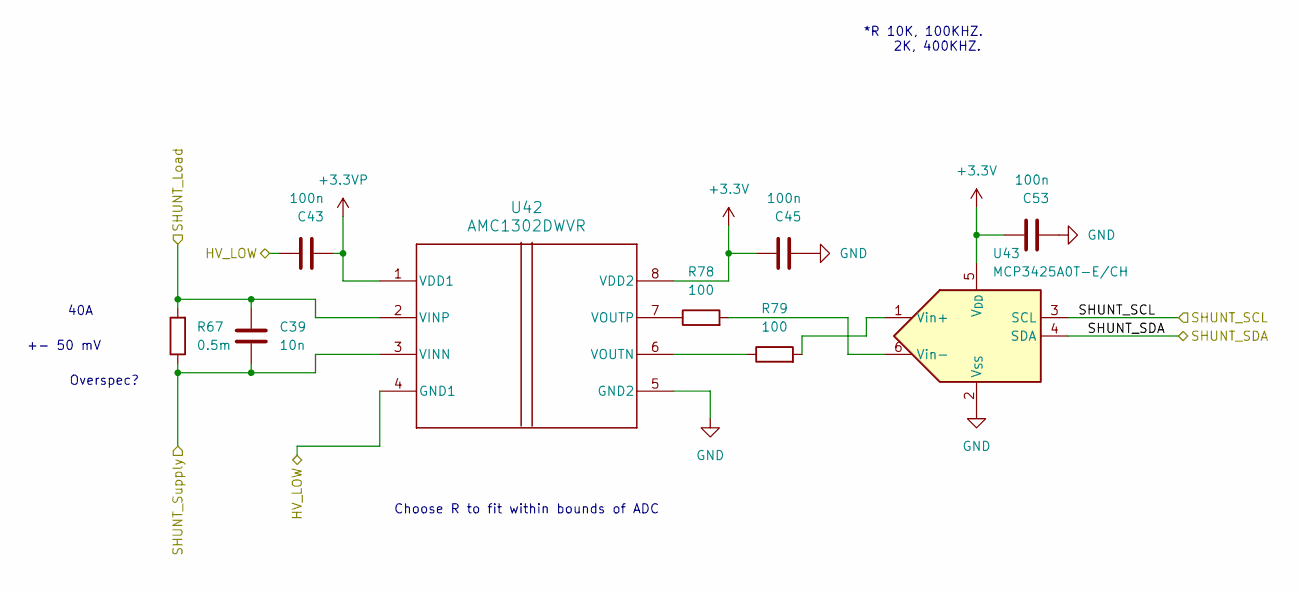
[picture p60: schematic shunt_sensor_circuit_main.kicad_sch]

Parts:
C39: 10n; C_0603_1608Metric_Pad1.08x0.95mm_HandSolder; Rating 50V; LCSC C57112
C43, C45, C53: 100n; C_0603_1608Metric_Pad1.08x0.95mm_HandSolder; Rating 50V; LCSC C14663
R67: 0.5m; RES-TH_HOFLQ60-100A-50MV-7H27; Rating 200V; LCSC C508587
R78, R79: 100; R_0603_1608Metric_Pad0.98x0.95mm_HandSolder; Rating 75V; LCSC C22775
U42: AMC1302DWVR; DWV0008A; LCSC C2863209
U43: MCP3425A0T-E/CH; SOT-23-6; LCSC C66823

Connections:
+3.3V: C45.1, C53.1, U42.8 (VDD2), U43.5 (V_{DD}); also elsewhere on the board
+3.3VP: C43.2, U42.1 (VDD1); also elsewhere on the board
/<NO NET>: U43.3 (SCL); also elsewhere on the board
/HV_BUS_NEG: C39.2, R67.1, U42.3 (VINN); also elsewhere on the board
/Main Contactor Low/RELAY_IN: C39.1, C43.1, R67.2, U42.2 (VINP), U42.4 (GND1); also elsewhere on the board
/SDA: U43.4 (SDA); also elsewhere on the board
GND: C45.2, C53.2, U42.5 (GND2), U43.2 (V_{SS}); also elsewhere on the board
unnamed: R79.1, U42.6 (VOUTN)
unnamed: R78.1, U42.7 (VOUTP)
unnamed: R79.2, U43.1 (Vin+)
unnamed: R78.2, U43.6 (Vin-)

Notes on the sheet:
Overspec?
40A
*R 10K, 100KHZ. 2K, 400KHZ.
Choose R to fit within bounds of ADC
+- 50 mV

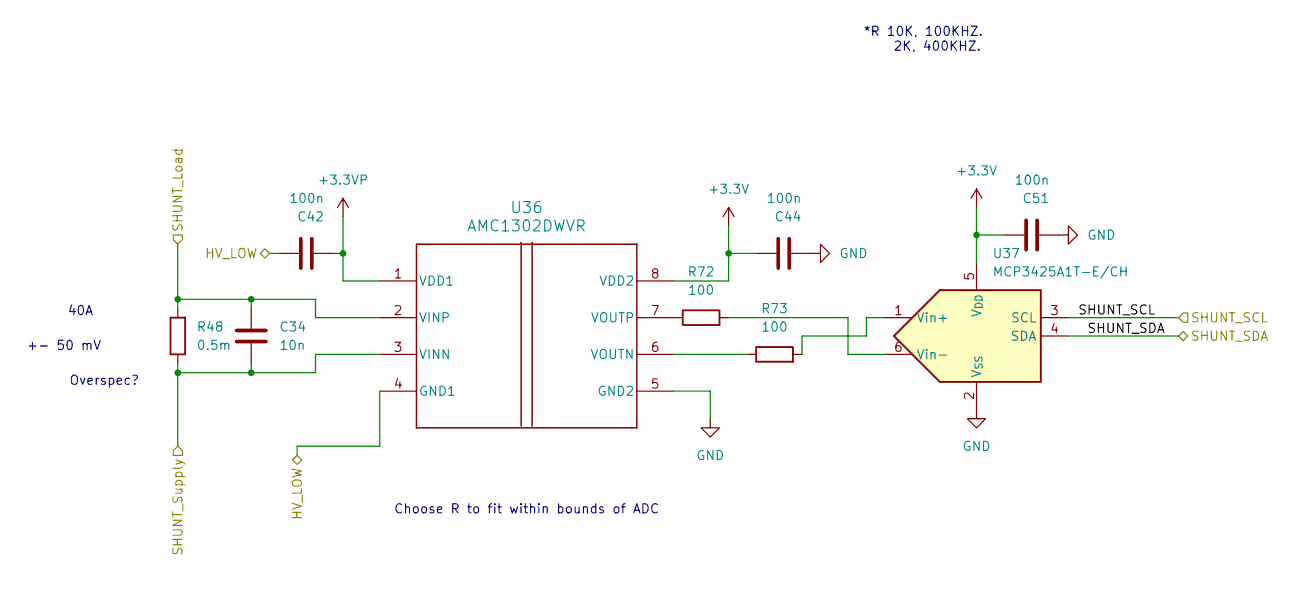
[picture p61: schematic shunt_sensor_circuit_40A.kicad_sch]

Parts:
C34: 10n; C_0603_1608Metric_Pad1.08x0.95mm_HandSolder; Rating 50V; LCSC C57112
C42, C44, C51: 100n; C_0603_1608Metric_Pad1.08x0.95mm_HandSolder; Rating 50V; LCSC C14663
R48: 0.5m; RES-TH_HOFLQ60-100A-50MV-7H27; Rating 200V; LCSC C508587
R72, R73: 100; R_0603_1608Metric_Pad0.98x0.95mm_HandSolder; Rating 75V; LCSC C22775
U36: AMC1302DWVR; DWV0008A; LCSC C2863209
U37: MCP3425A1T-E/CH; SOT-23-6; LCSC C625479

Connections:
+3.3V: C44.1, C51.1, U36.8 (VDD2), U37.5 (V_{DD}); also elsewhere on the board
+3.3VP: C42.2, U36.1 (VDD1); also elsewhere on the board
/<NO NET>: U37.3 (SCL); also elsewhere on the board
/HV_BUS_NEG: C34.1, C42.1, R48.2, U36.2 (VINP), U36.4 (GND1); also elsewhere on the board
/MC Current Sense/SHUNT_Supply: C34.2, R48.1, U36.3 (VINN); also elsewhere on the board
/SDA: U37.4 (SDA); also elsewhere on the board
GND: C44.2, C51.2, U36.5 (GND2), U37.2 (V_{SS}); also elsewhere on the board
unnamed: R73.1, U36.6 (VOUTN)
unnamed: R72.1, U36.7 (VOUTP)
unnamed: R73.2, U37.1 (Vin+)
unnamed: R72.2, U37.6 (Vin-)

Notes on the sheet:
Overspec?
40A
*R 10K, 100KHZ. 2K, 400KHZ.
Choose R to fit within bounds of ADC
+- 50 mV

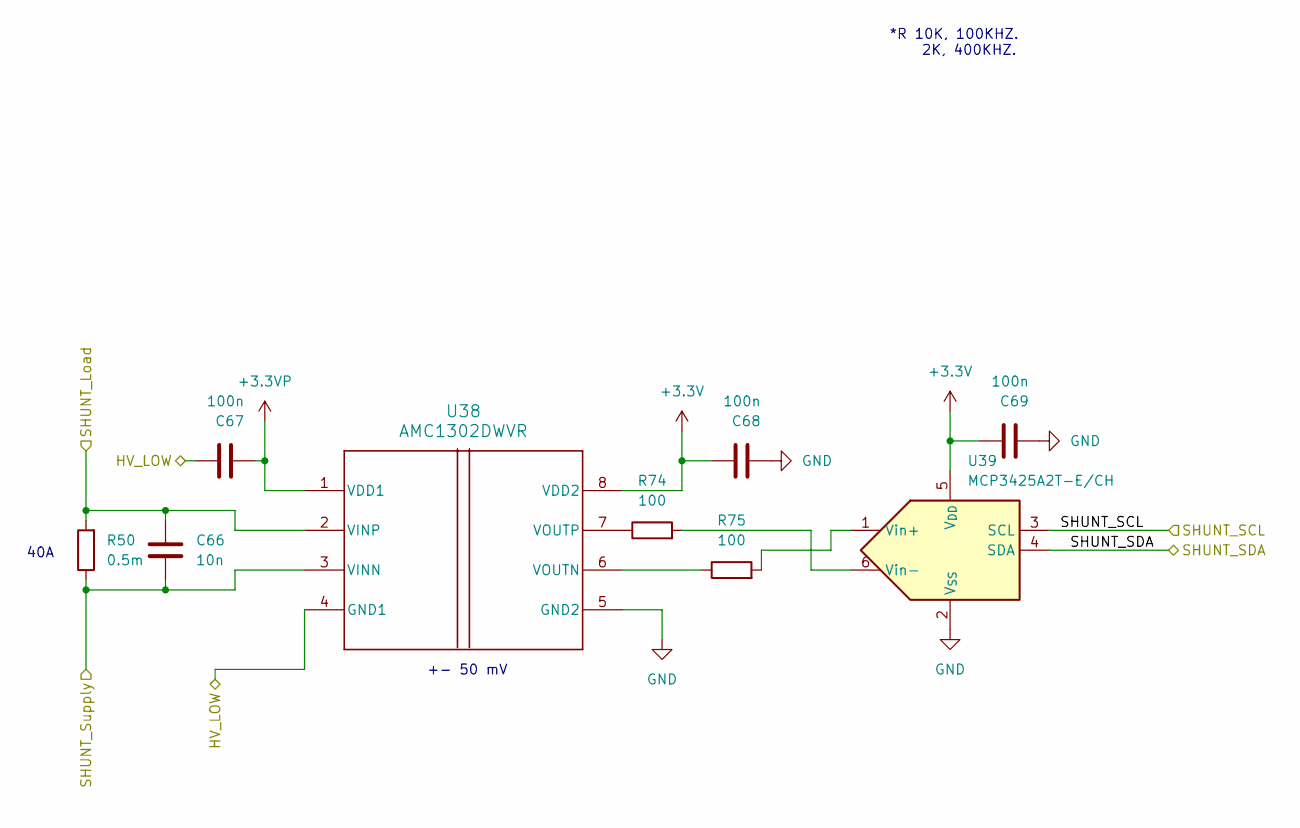
[picture p62: schematic shunt_sensor_circuit_mppt.kicad_sch]

Parts:
C66: 10n; C_0603_1608Metric_Pad1.08x0.95mm_HandSolder; Rating 50V; LCSC C57112
C67, C68, C69: 100n; C_0603_1608Metric_Pad1.08x0.95mm_HandSolder; Rating 50V; LCSC C14663
R50: 0.5m; RES-TH_HOFLQ60-100A-50MV-7H27; Rating 200V; LCSC C508587
R74, R75: 100; R_0603_1608Metric_Pad0.98x0.95mm_HandSolder; Rating 75V; LCSC C22775
U38: AMC1302DWVR; DWV0008A; LCSC C2863209
U39: MCP3425A2T-E/CH; SOT-23-6; LCSC C625480

Connections:
+3.3V: C68.1, C69.1, U38.8 (VDD2), U39.5 (V_{DD}); also elsewhere on the board
+3.3VP: C67.2, U38.1 (VDD1); also elsewhere on the board
/<NO NET>: U39.3 (SCL); also elsewhere on the board
/Elmar Racing MPPTS/HV_BUS_NEG: C66.2, R50.1, U38.3 (VINN); also elsewhere on the board
/HV_BUS_NEG: C66.1, C67.1, R50.2, U38.2 (VINP), U38.4 (GND1); also elsewhere on the board
/SDA: U39.4 (SDA); also elsewhere on the board
GND: C68.2, C69.2, U38.5 (GND2), U39.2 (V_{SS}); also elsewhere on the board
unnamed: R75.1, U38.6 (VOUTN)
unnamed: R74.1, U38.7 (VOUTP)
unnamed: R75.2, U39.1 (Vin+)
unnamed: R74.2, U39.6 (Vin-)

Notes on the sheet:
40A
*R 10K, 100KHZ. 2K, 400KHZ.
+- 50 mV

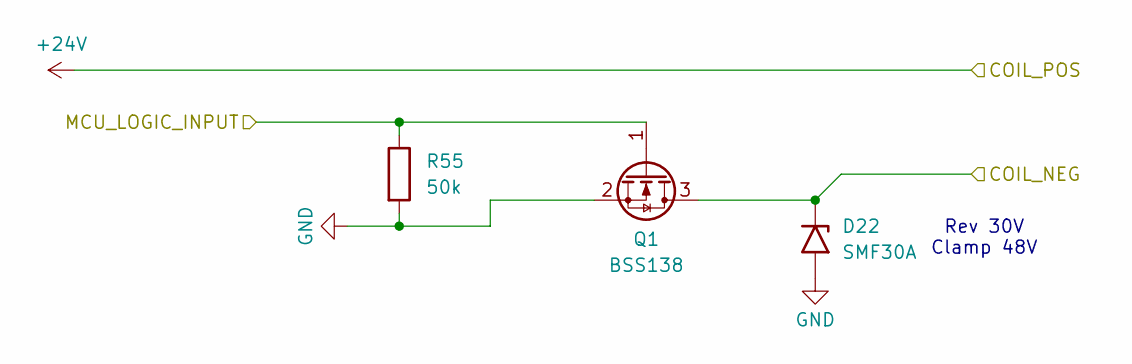
[picture p63: schematic RelayProtectionCircuit.kicad_sch]

Parts:
D22: SMF30A; D_SMF; LCSC C19077518
Q1: BSS138; SOT-23; LCSC C7420339
R55: 50k; R_0603_1608Metric_Pad0.98x0.95mm_HandSolder; LCSC C23184

Connections:
/Elmar Racing MPPTS/COIL_RET_1: D22.1 (A1), Q1.3 (D); also elsewhere on the board
/Gate.PV1: Q1.1 (G), R55.1; also elsewhere on the board
GND: D22.2 (A2), Q1.2 (S), R55.2; also elsewhere on the board

Parts of its further copies:
D1, D5, D6, D27, D28, D29, D30: SMF30A; D_SMF; LCSC C19077518
Q2, Q3, Q9, Q10, Q11, Q12, Q13: BSS138; SOT-23; LCSC C7420339
R24, R33, R42, R56, R59, R60, R68: 50k; R_0603_1608Metric_Pad0.98x0.95mm_HandSolder; LCSC C23184

Connections of its further copies:
/Elmar Racing MPPTS/COIL_RET_2: D27.1 (A1), Q2.3 (D); also elsewhere on the board
/Elmar Racing MPPTS/COIL_RET_3: D28.1 (A1), Q3.3 (D); also elsewhere on the board
/Gate.DIS: Q12.1 (G), R68.1; also elsewhere on the board
/Gate.HIGH: Q9.1 (G), R24.1; also elsewhere on the board
/Gate.LOW: Q10.1 (G), R33.1; also elsewhere on the board
/Gate.MC: Q13.1 (G), R42.1; also elsewhere on the board
/Gate.PRE: Q11.1 (G), R60.1; also elsewhere on the board
/Gate.PV2: Q2.1 (G), R56.1; also elsewhere on the board
/Gate.PV3: Q3.1 (G), R59.1; also elsewhere on the board
/MC Relay/RELAY_PROTECTION_CIRCUIT/COIL_NEG: D6.1 (A1), Q13.3 (D); also elsewhere on the board
/Main Contactor High/RELAY_PROTECTION_CIRCUIT/COIL_NEG: D1.1 (A1), Q9.3 (D); also elsewhere on the board
/Main Contactor Low/RELAY_PROTECTION_CIRCUIT/COIL_NEG: D5.1 (A1), Q10.3 (D); also elsewhere on the board
/Pre & Dis Charge/RELAY_PROTECTION_CIRCUIT1/COIL_NEG: D30.1 (A1), Q12.3 (D); also elsewhere on the board
/Pre & Dis Charge/RELAY_PROTECTION_CIRCUIT/COIL_NEG: D29.1 (A1), Q11.3 (D); also elsewhere on the board
GND: D1.2 (A2), D5.2 (A2), D6.2 (A2), D27.2 (A2), D28.2 (A2), D29.2 (A2), D30.2 (A2), Q2.2 (S), Q3.2 (S), Q9.2 (S), Q10.2 (S), Q11.2 (S), Q12.2 (S), Q13.2 (S), R24.2, R33.2, R42.2, R56.2, R59.2, R60.2, R68.2; also elsewhere on the board

Notes on the sheet:
Rev 30V Clamp 48V
