Rutherfurrd/Sakura-1---High-Voltage-Power-Distribution-System/Power Distribution Board/BatteryBoard.kicad_pcb

## KiCad design Power Distribution Board/BatteryBoard.kicad_pcb (continued)

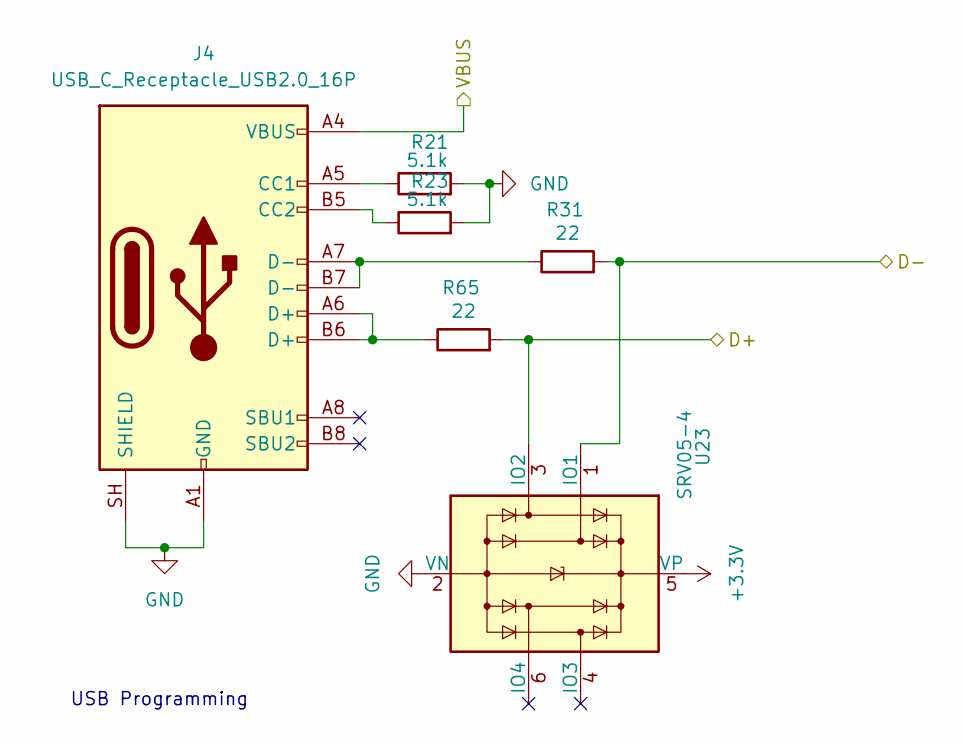
[picture p64: schematic VUSB_Circuit.kicad_sch]

Parts:
J4: USB_C_Receptacle_USB2.0_16P; USB_C_Receptacle_HRO_TYPE-C-31-M-12; DigiKey_Part_Number 2223-UJ20-C-H-G-SMT-1-P16-TRCT-ND
R21, R23: 5.1k; R_0603_1608Metric_Pad0.98x0.95mm_HandSolder; LCSC C23186
R31, R65: 22; R_0603_1608Metric_Pad0.98x0.95mm_HandSolder; LCSC C23345
U23: SRV05-4; SOT-23-6; LCSC C85364

Connections:
+3.3V: U23.5 (VP); also elsewhere on the board
/STM32_CONTROL/USC_CIRCUIT/D+: R65.2, U23.3 (IO2); also elsewhere on the board
/STM32_CONTROL/USC_CIRCUIT/D-: R31.2, U23.1 (IO1); also elsewhere on the board
/STM32_CONTROL/USC_CIRCUIT/VBUS: J4.A4 (VBUS), J4.A9 (VBUS), J4.B4 (VBUS), J4.B9 (VBUS); also elsewhere on the board
GND: J4.A1 (GND), J4.A12 (GND), J4.B1 (GND), J4.B12 (GND), J4.SH (SHIELD), R21.2, R23.2, U23.2 (VN); also elsewhere on the board
unnamed: J4.A5 (CC1), R21.1
unnamed: J4.B5 (CC2), R23.1
unnamed: J4.A6 (D+), J4.B6 (D+), R65.1
unnamed: J4.A7 (D-), J4.B7 (D-), R31.1

Notes on the sheet:
USB Programming

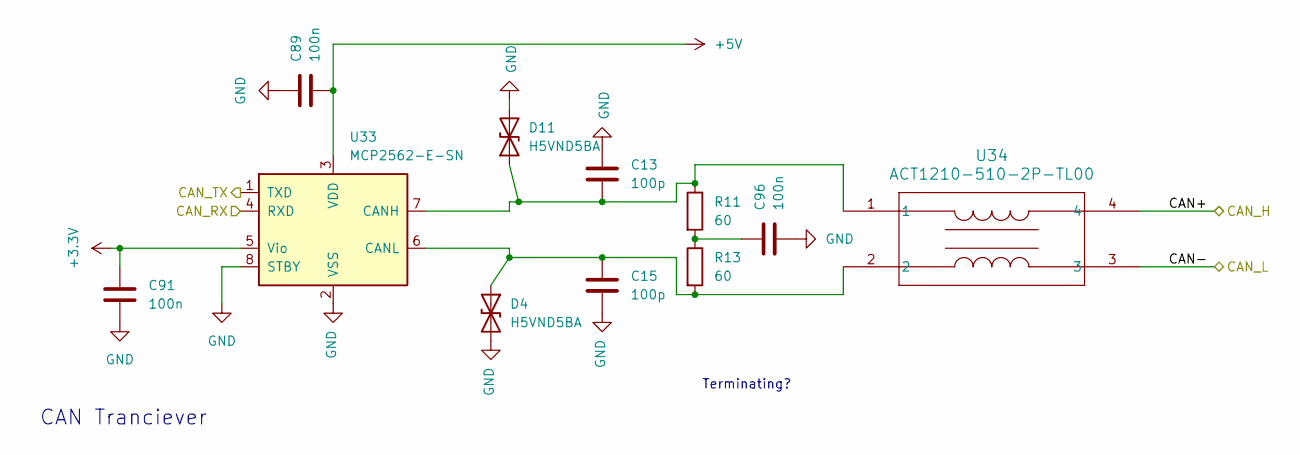
[picture p65: schematic CAN Transceiver - MCP2562.kicad_sch]

Parts:
C13, C15: 100p; C_0402_1005Metric_Pad0.74x0.62mm_HandSolder; LCSC C1546
C89, C91, C96: 100n; C_0603_1608Metric_Pad1.08x0.95mm_HandSolder; Rating 50V; LCSC C14663
D4, D11: H5VND5BA; D_SOD-523; LCSC C42413899
R11, R13: 60; R_0402_1005Metric_Pad0.72x0.64mm_HandSolder; LCSC C60310
U33: MCP2562-E-SN; SOIC-8_3.9x4.9mm_P1.27mm; LCSC C124016
U34: ACT1210-510-2P-TL00; CHOKE_10-2P-TL00_TDK; LCSC C95572

Connections:
+3.3V: C91.1, U33.5 (Vio); also elsewhere on the board
+5V: C89.2, U33.3 (VDD); also elsewhere on the board
/CAN+: U34.4; also elsewhere on the board
/CAN-: U34.3; also elsewhere on the board
/STM32_CONTROL/CAN Transceiver - MPPT Network/CAN_RX: U33.4 (RXD); also elsewhere on the board
/STM32_CONTROL/CAN Transceiver - MPPT Network/CAN_TX: U33.1 (TXD); also elsewhere on the board
GND: C13.1, C15.2, C89.1, C91.2, C96.2, D4.2 (A2), D11.2 (A2), U33.2 (VSS), U33.8 (STBY); also elsewhere on the board
unnamed: C96.1, R11.2, R13.1
unnamed: C15.1, D4.1 (A1), R13.2, U33.6 (CANL), U34.2
unnamed: C13.2, D11.1 (A1), R11.1, U33.7 (CANH), U34.1

Notes on the sheet:
CAN Tranciever
Terminating?

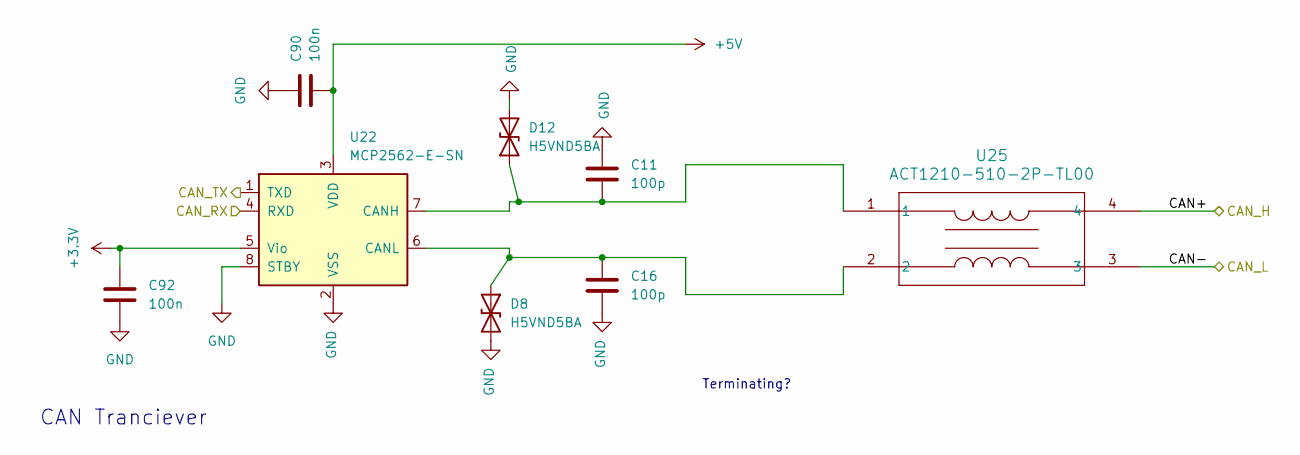
[picture p66: schematic CAN Transceiver - MCP2562 - Non term.kicad_sch]

Parts:
C11, C16: 100p; C_0402_1005Metric_Pad0.74x0.62mm_HandSolder; LCSC C1546
C90, C92: 100n; C_0603_1608Metric_Pad1.08x0.95mm_HandSolder; Rating 50V; LCSC C14663
D8, D12: H5VND5BA; D_SOD-523; LCSC C42413899
U22: MCP2562-E-SN; SOIC-8_3.9x4.9mm_P1.27mm; LCSC C124016
U25: ACT1210-510-2P-TL00; CHOKE_10-2P-TL00_TDK; LCSC C95572

Connections:
+3.3V: C92.1, U22.5 (Vio); also elsewhere on the board
+5V: C90.2, U22.3 (VDD); also elsewhere on the board
/STM32_CONTROL/CAN Transceiver - Car Network/CAN+: U25.4; also elsewhere on the board
/STM32_CONTROL/CAN Transceiver - Car Network/CAN-: U25.3; also elsewhere on the board
/STM32_CONTROL/CAN Transceiver - Car Network/CAN_RX: U22.4 (RXD); also elsewhere on the board
/STM32_CONTROL/CAN Transceiver - Car Network/CAN_TX: U22.1 (TXD); also elsewhere on the board
GND: C11.1, C16.2, C90.1, C92.2, D8.2 (A2), D12.2 (A2), U22.2 (VSS), U22.8 (STBY); also elsewhere on the board
unnamed: C16.1, D8.1 (A1), U22.6 (CANL), U25.2
unnamed: C11.2, D12.1 (A1), U22.7 (CANH), U25.1

Notes on the sheet:
CAN Tranciever
Terminating?

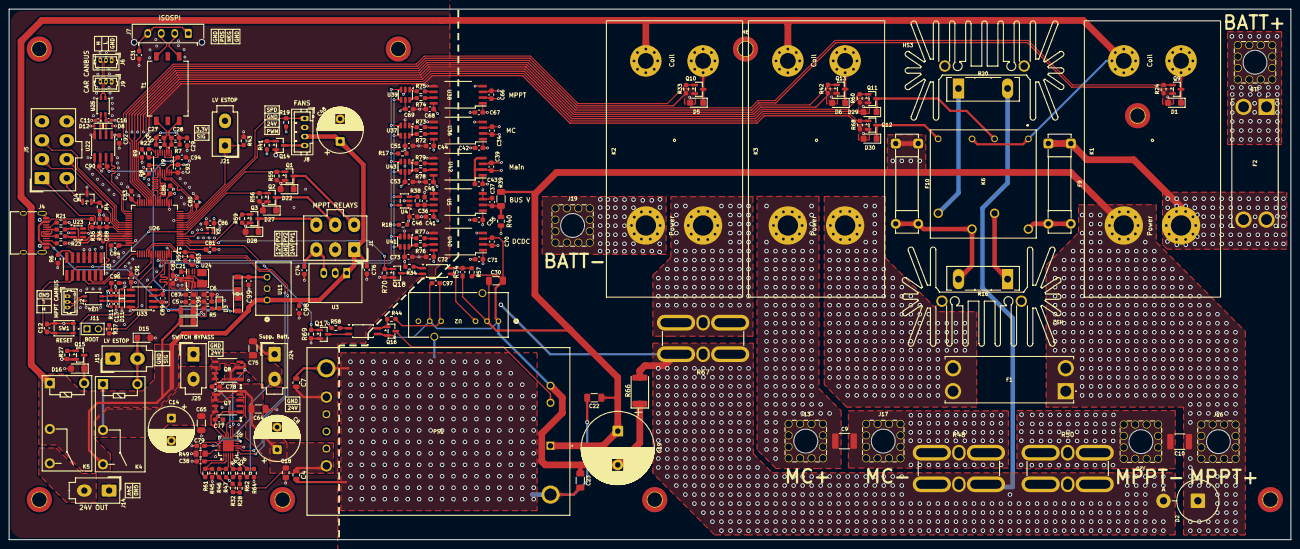
[picture p67: board BatteryBoard.kicad_pcb from above]

Board: 4 copper layers, 284.3 x 117.7 mm, 247 parts (0 on the bottom side), 145 nets.
