Rutherfurrd/Sakura-1---High-Voltage-Power-Distribution-System/Supplementary Battery Fusebox/Supplementary Breakout.kicad_pcb

## KiCad design Supplementary Battery Fusebox/Supplementary Breakout.kicad_pcb (2026-10-22)

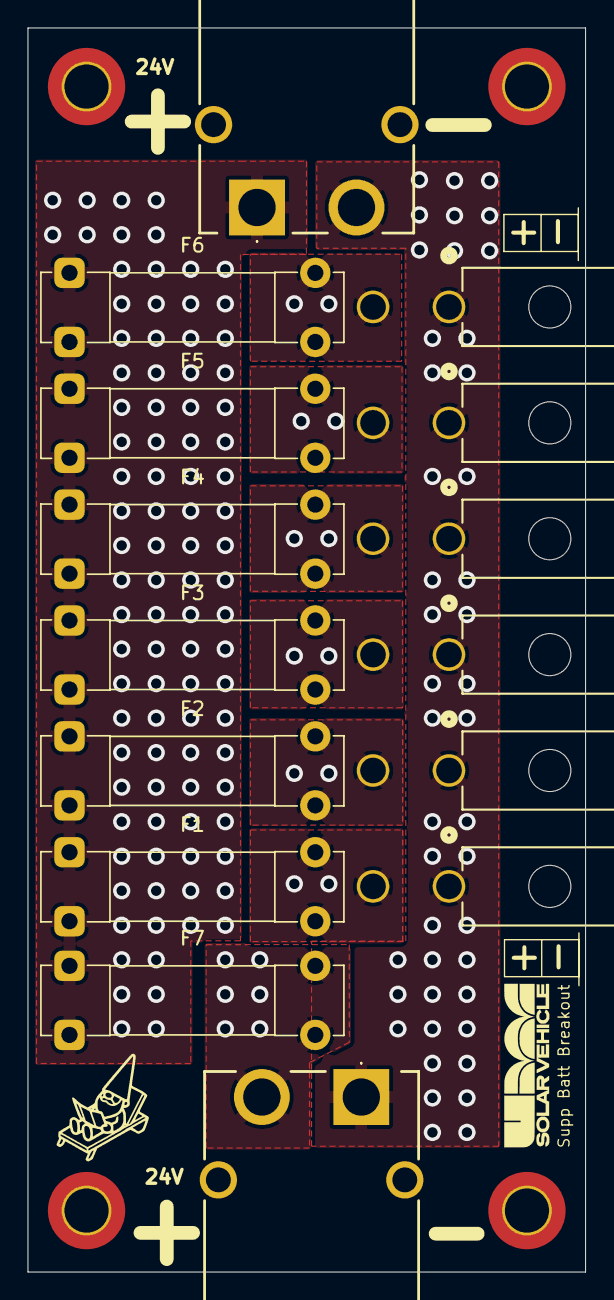
[picture p68: board Supplementary Breakout.kicad_pcb from above]

Board: 2 copper layers, 40.4 x 90.1 mm, 19 parts (0 on the bottom side), 9 nets, no tracks yet.

Parts:
F1, F2, F3, F4, F5, F6, F7: 3568 Holder; Fuseholder_Clip-5x20mm_Bel_FC-203-22_Lateral_P17.80x5.00mm_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
H1, H2, H3, H4: MountingHole_Pad; MountingHole_3.2mm_M3_DIN965_Pad_TopBottom
J1, J7: XT60; XT60PWM
J8, J9, J10, J11, J12, J13: Molex 5569; CONN_5569-02A_MOL

Connections:
/Supp+: F1.1, F2.1, F3.1, F4.1, F5.1, F6.1, F7.1, J1.1
/Supp-: J1.2, J7.1, J8.1, J9.1, J10.1, J11.1, J12.1, J13.1
unnamed: F7.2, J7.2
unnamed: F1.2, J8.2
unnamed: F2.2, J9.2
unnamed: F3.2, J10.2
unnamed: F4.2, J11.2
unnamed: F5.2, J12.2
unnamed: F6.2, J13.2
