Rutherfurrd/Sakura-1---High-Voltage-Power-Distribution-System/(commit log)

2026-10-22 Import from private org repo
    [24V_DCDC.kicad_sch, BMS.kicad_sch, BOM-MPPT Breakout.csv, BOM-Supplementary Breakout.csv, Batt_box.STEP, Batt_box_assem.SLDASM, Battery Board, No Silkscreen.step, Battery Board.step]
2026-10-22 Printed Schematics
